shrekwrecks/foc_rpi_micropy/dual_core_foc_micropy.pdf

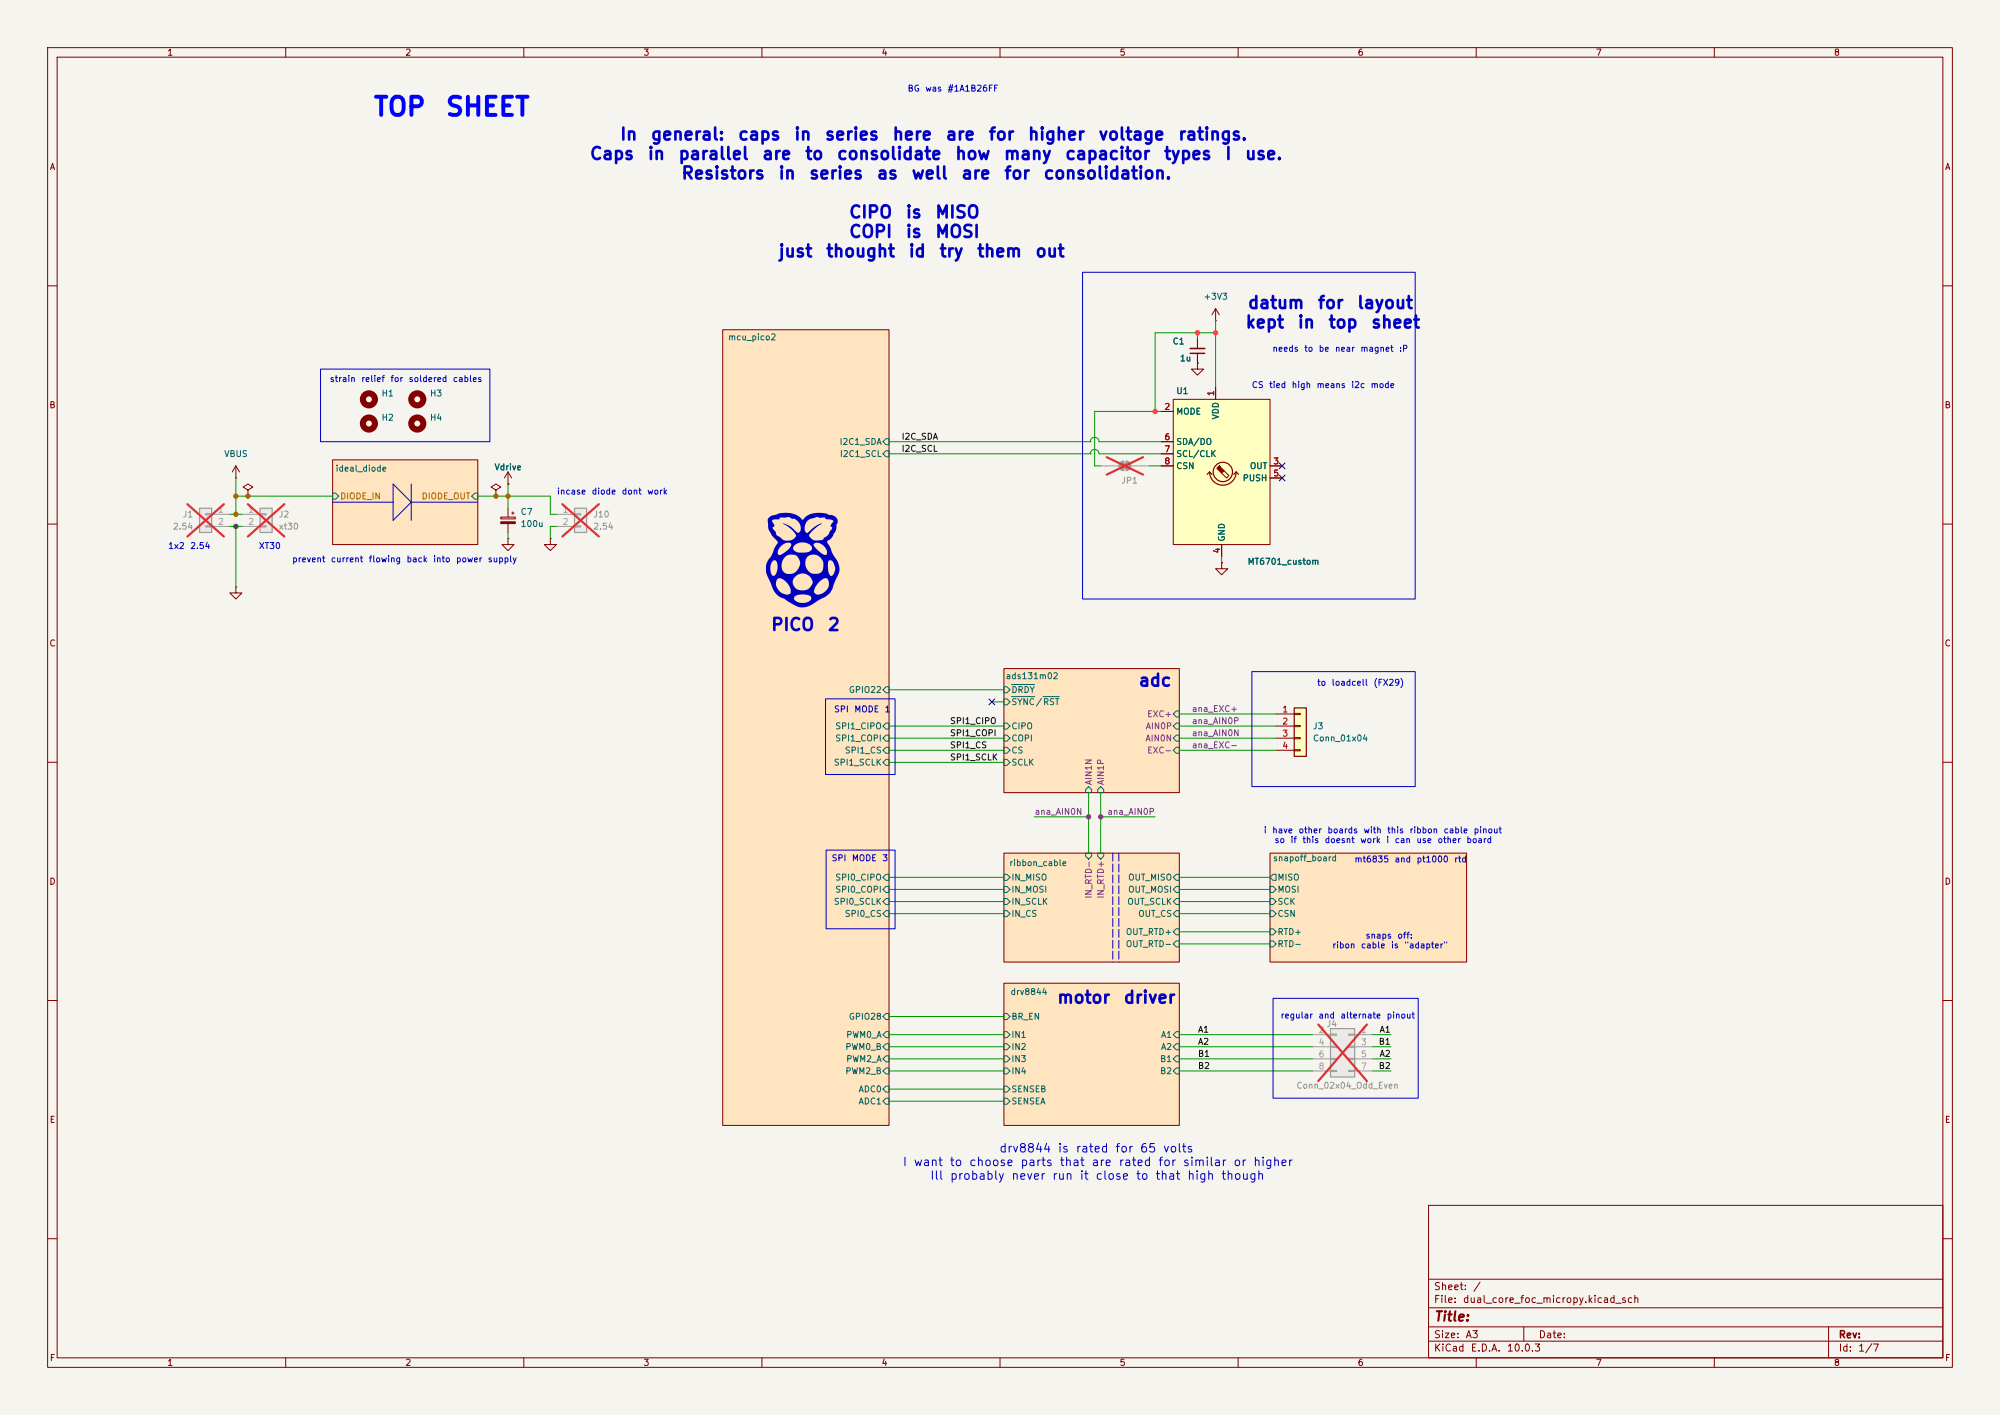
[picture p1: page 1]

strain relief for soldered cables TOP SHEET

In general: caps in series here are for higher voltage ratings.
Caps in parallel are to consolidate how many capacitor types I use.

Resistors in series as well are for consolidation.

just thought id try them out

needs to be near magnet :P datum for layout
kept in top sheet
I2C_SDA SPI1_CIPO
I2C1_SDA SPI0_CIPO
I2C1_SCL

ana_AIN0P | 2

SPI1_COPI SPI1_CS | | ana_AIN0N | 3

ana_EXC- | 4

i have other boards with this ribbon cable pinout so if this doesnt work i can use other board

CSN MISO MOSI SCK

snaps off: ribon cable is "adapter"

regular and alternate pinout
J4 Conn_02x04_Odd_Even

drv8844 is rated for 65 volts

I want to choose parts that are rated for similar or higher
Ill probably never run it close to that high though

Size: A3 | Rev: | F Date:
KiCad E.D.A. 10.0.3 | Id: 1/7

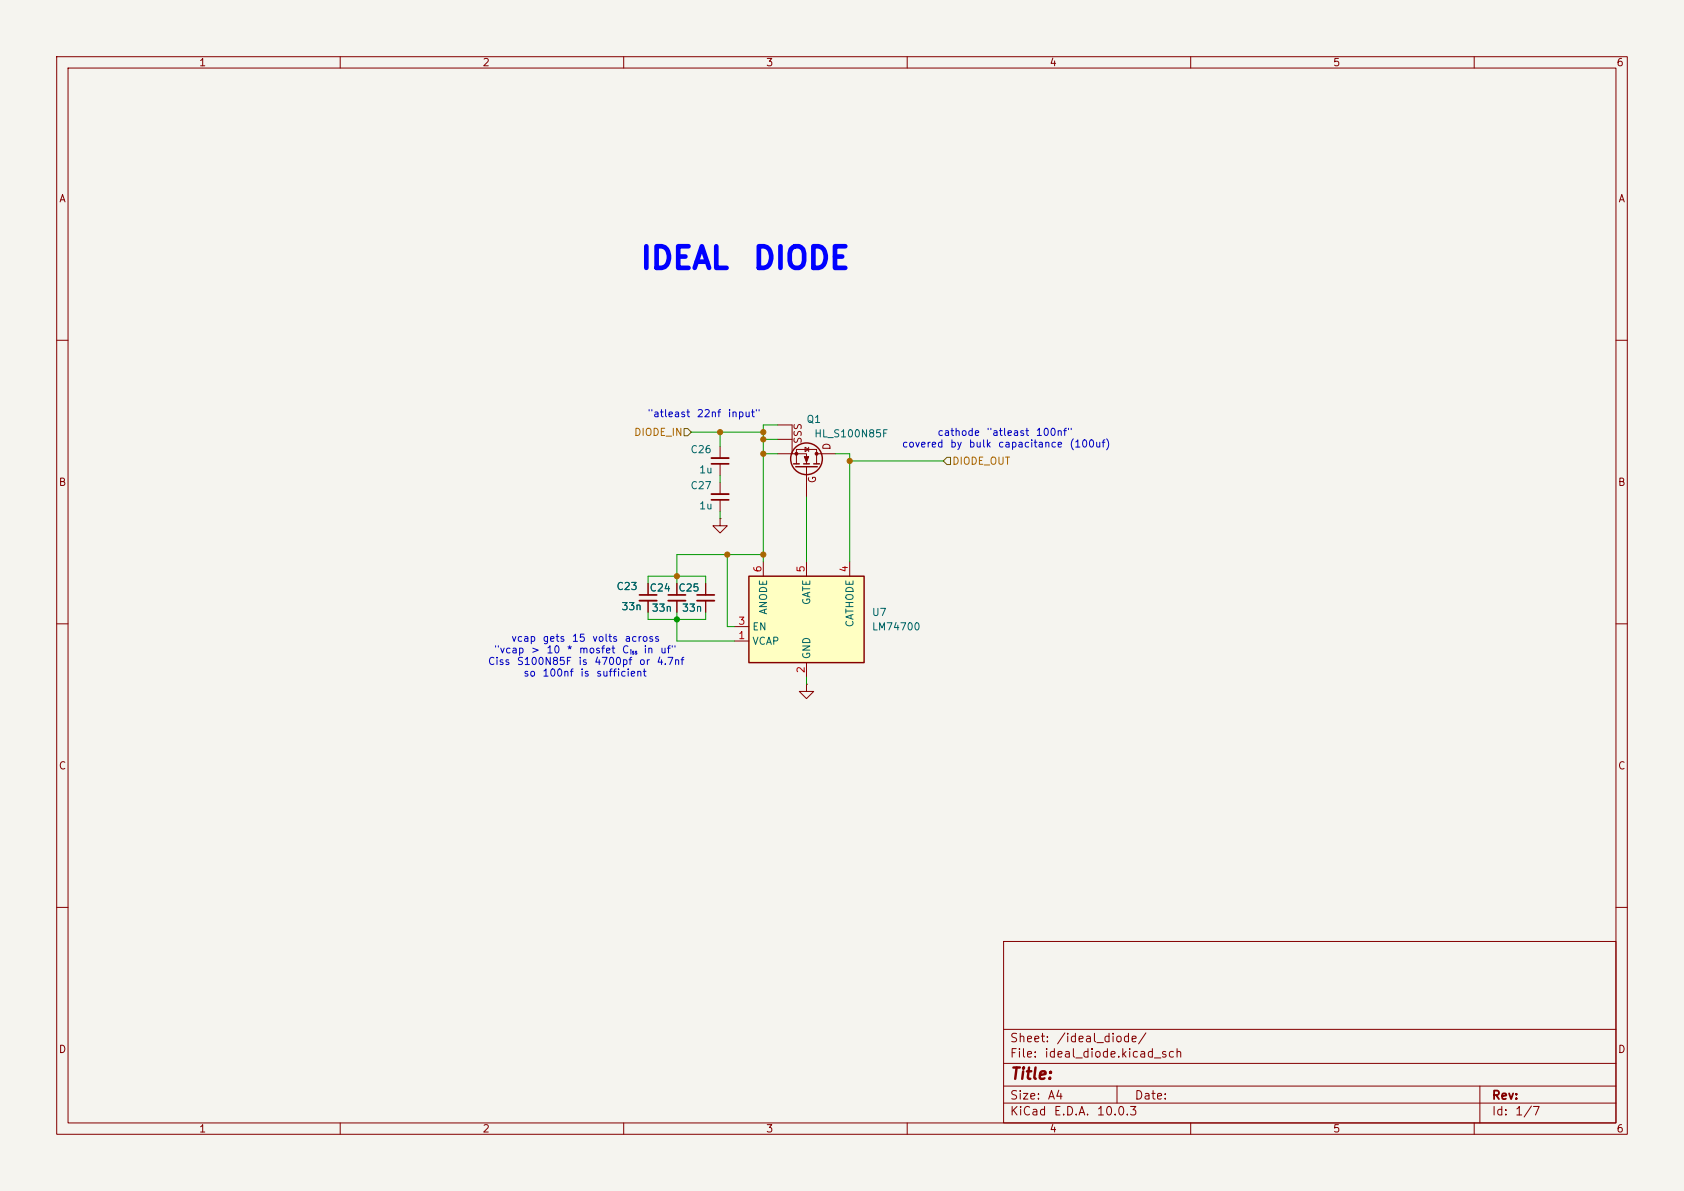
[picture p2: page 2]

"vcap > 10 * mosfet Ciss in uf" Ciss S100N85F is 4700pf or 4.7nf so 100nf is sufficientIDEAL DIODE

DIODE_OUT cathode "atleast 100nf" covered by bulk capacitance (100uf) "atleast 22nf input"
33n DIODE_IN

vcap gets 15 volts across

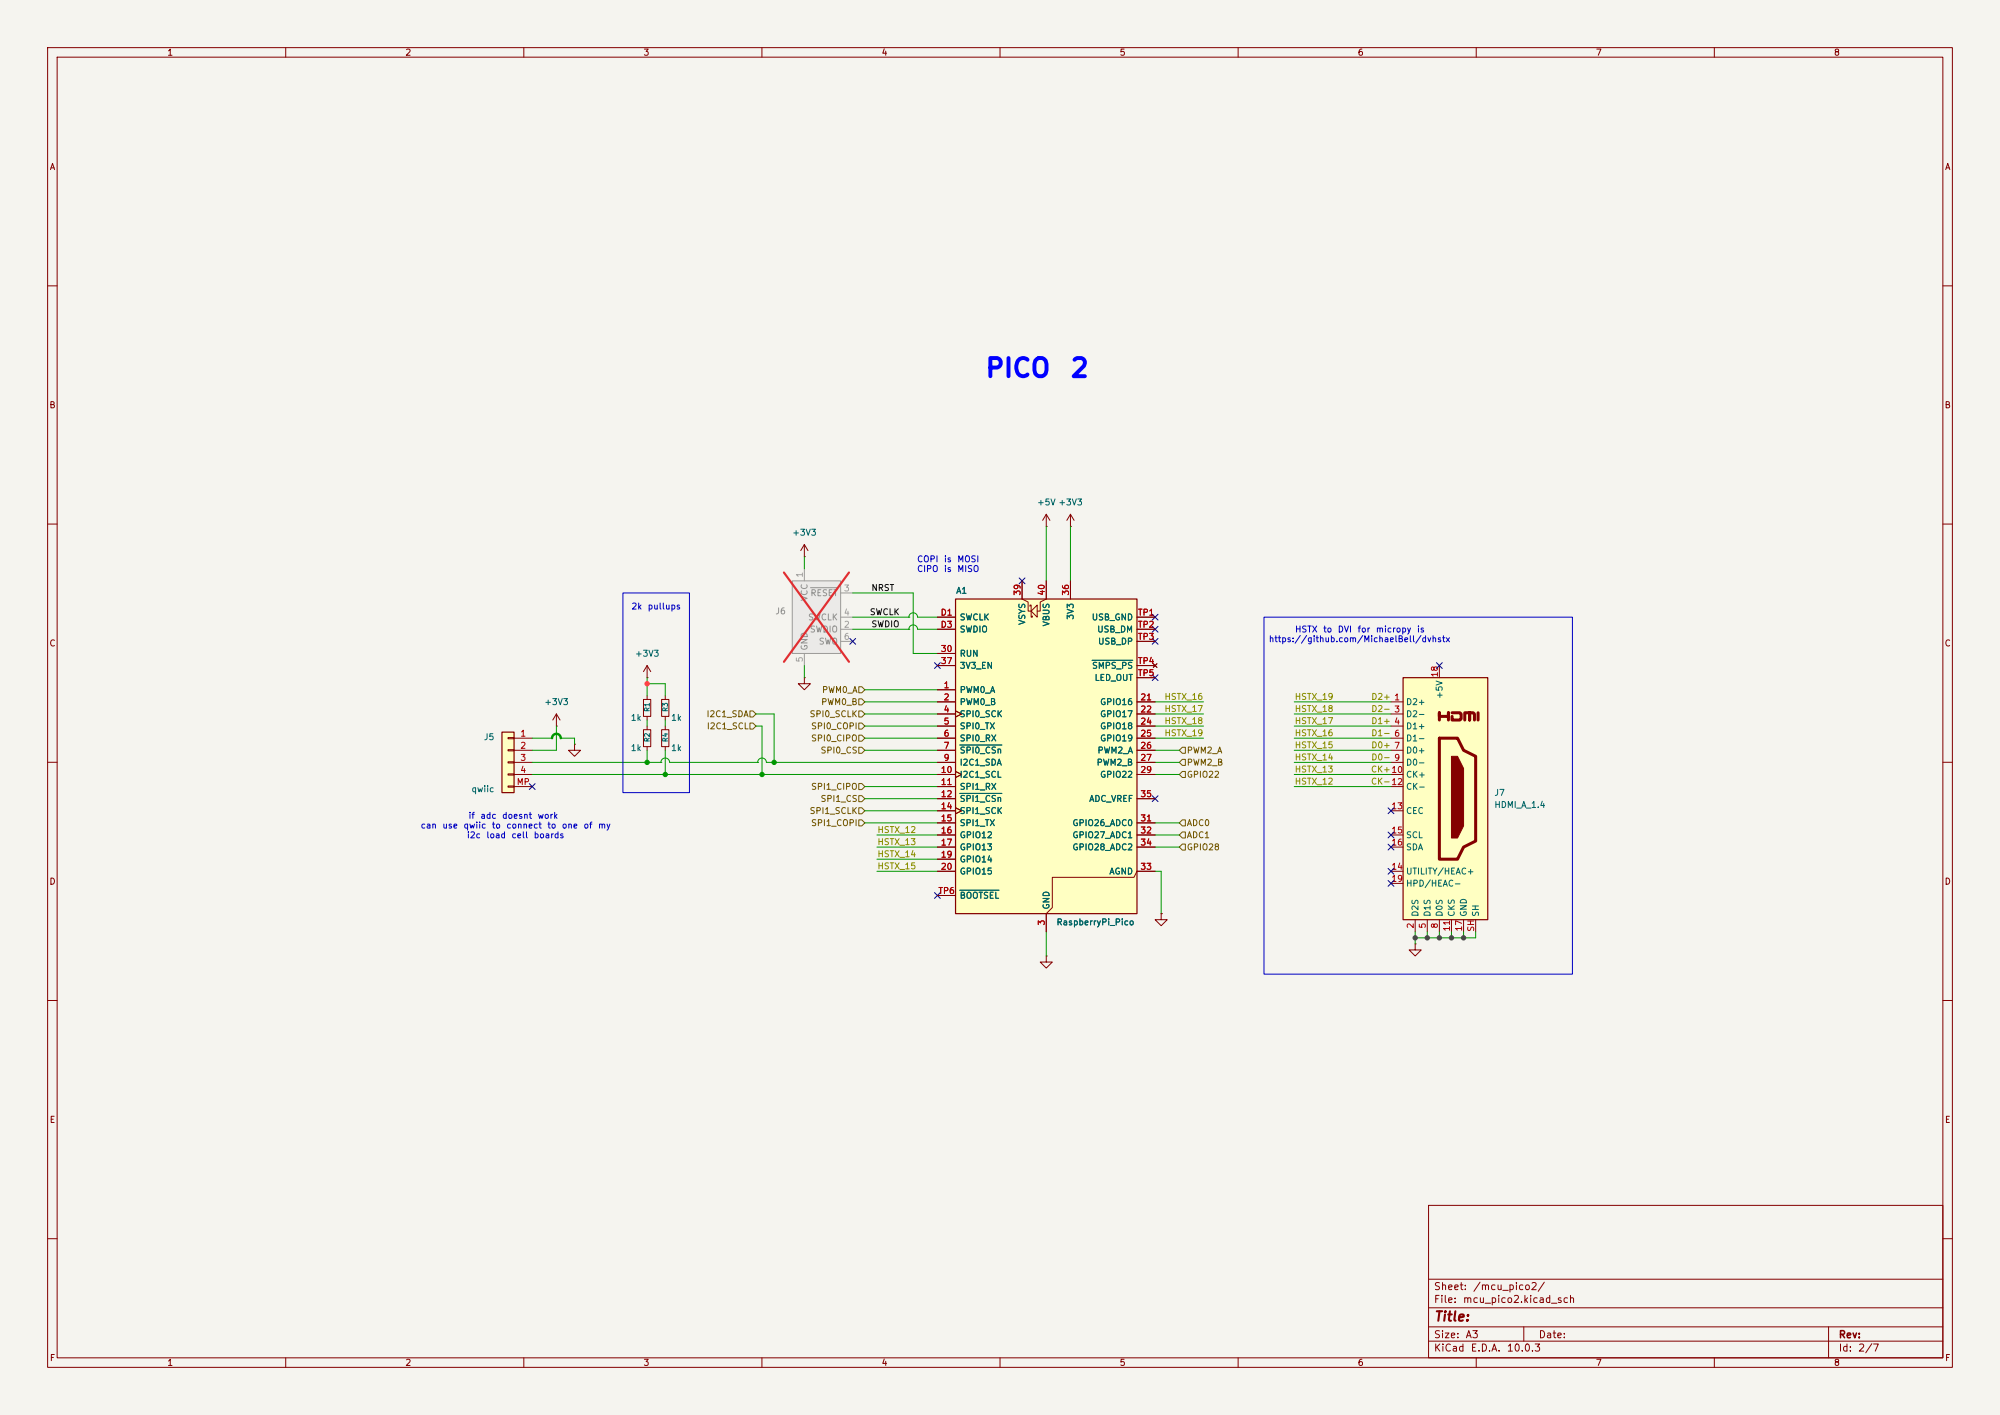
[picture p3: page 3]

8 D0- 9 CK+ 10 CKS 11 CK- 12 CEC 13 UTILITY/HEAC+ 14

if adc doesnt work can use qwiic to connect to one of my

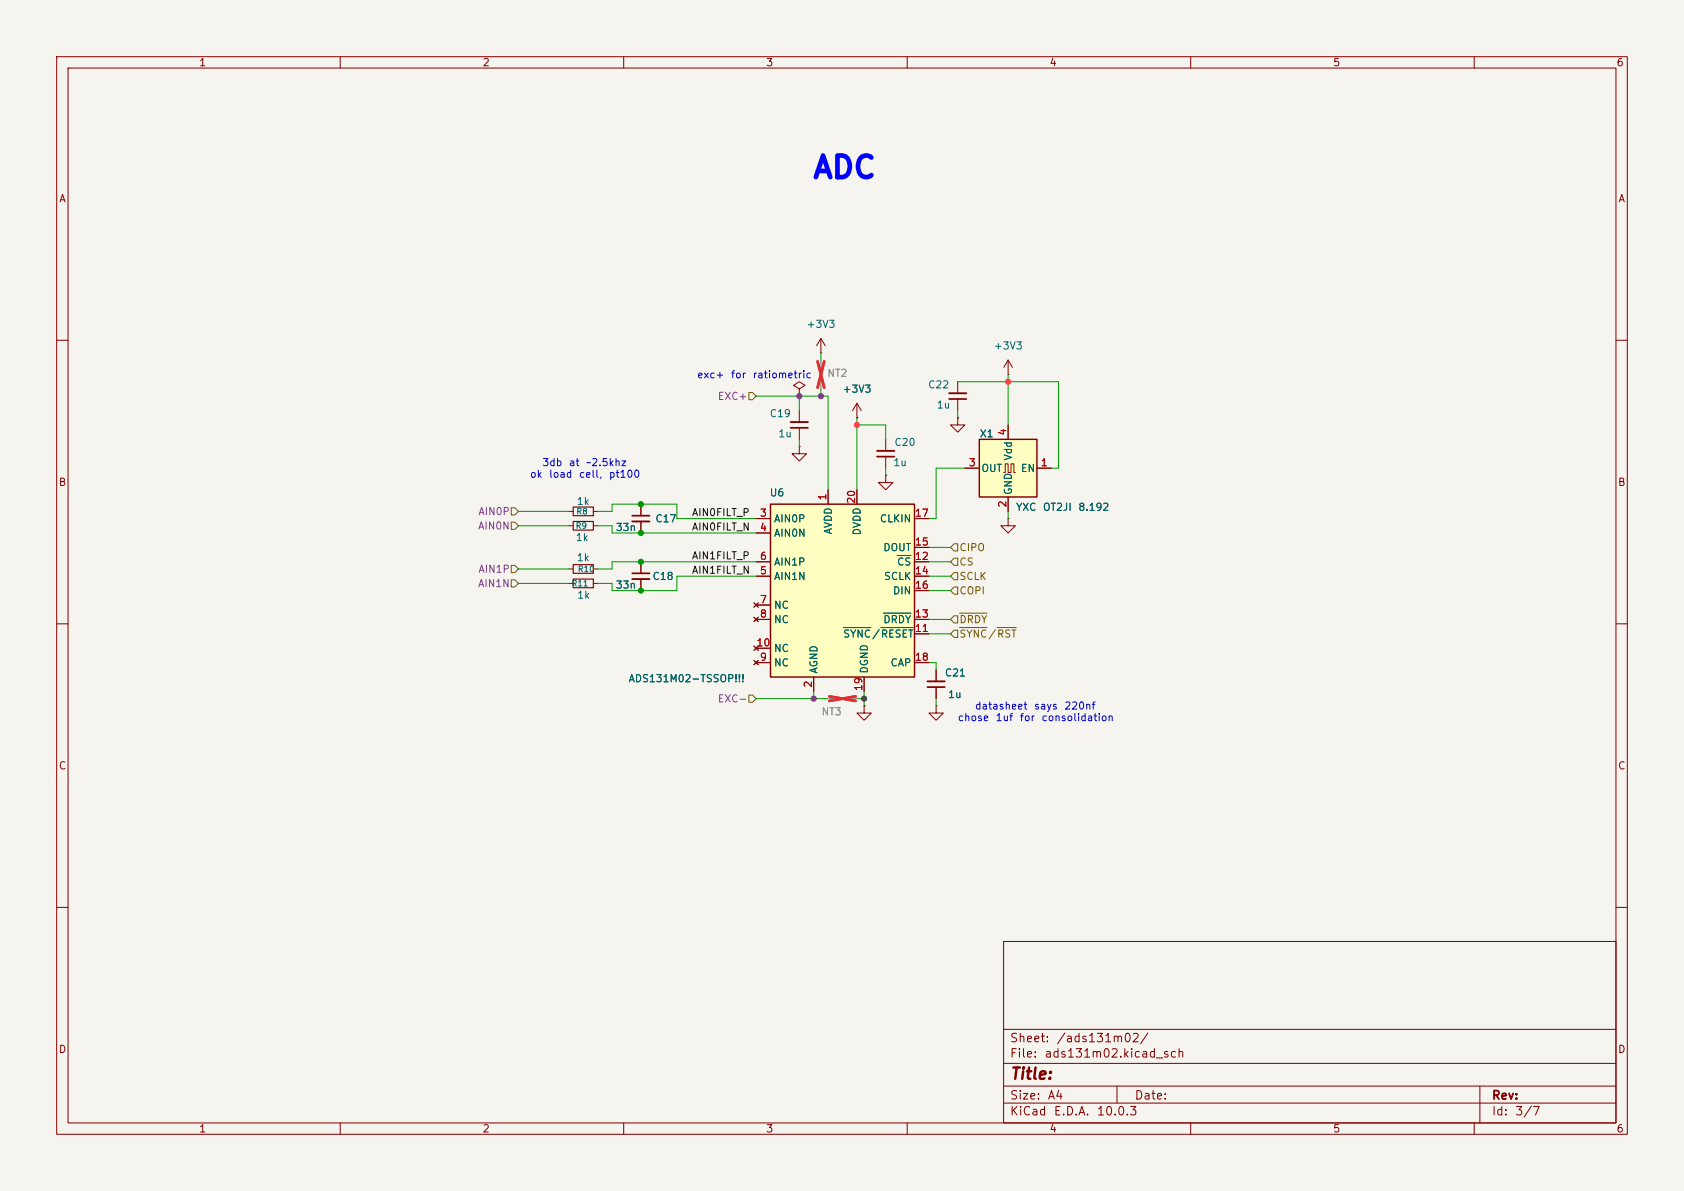
[picture p4: page 4]

CIPO
DRDY SYNC/RST COPI SCLK

datasheet says 220nf chose 1uf for consolidation

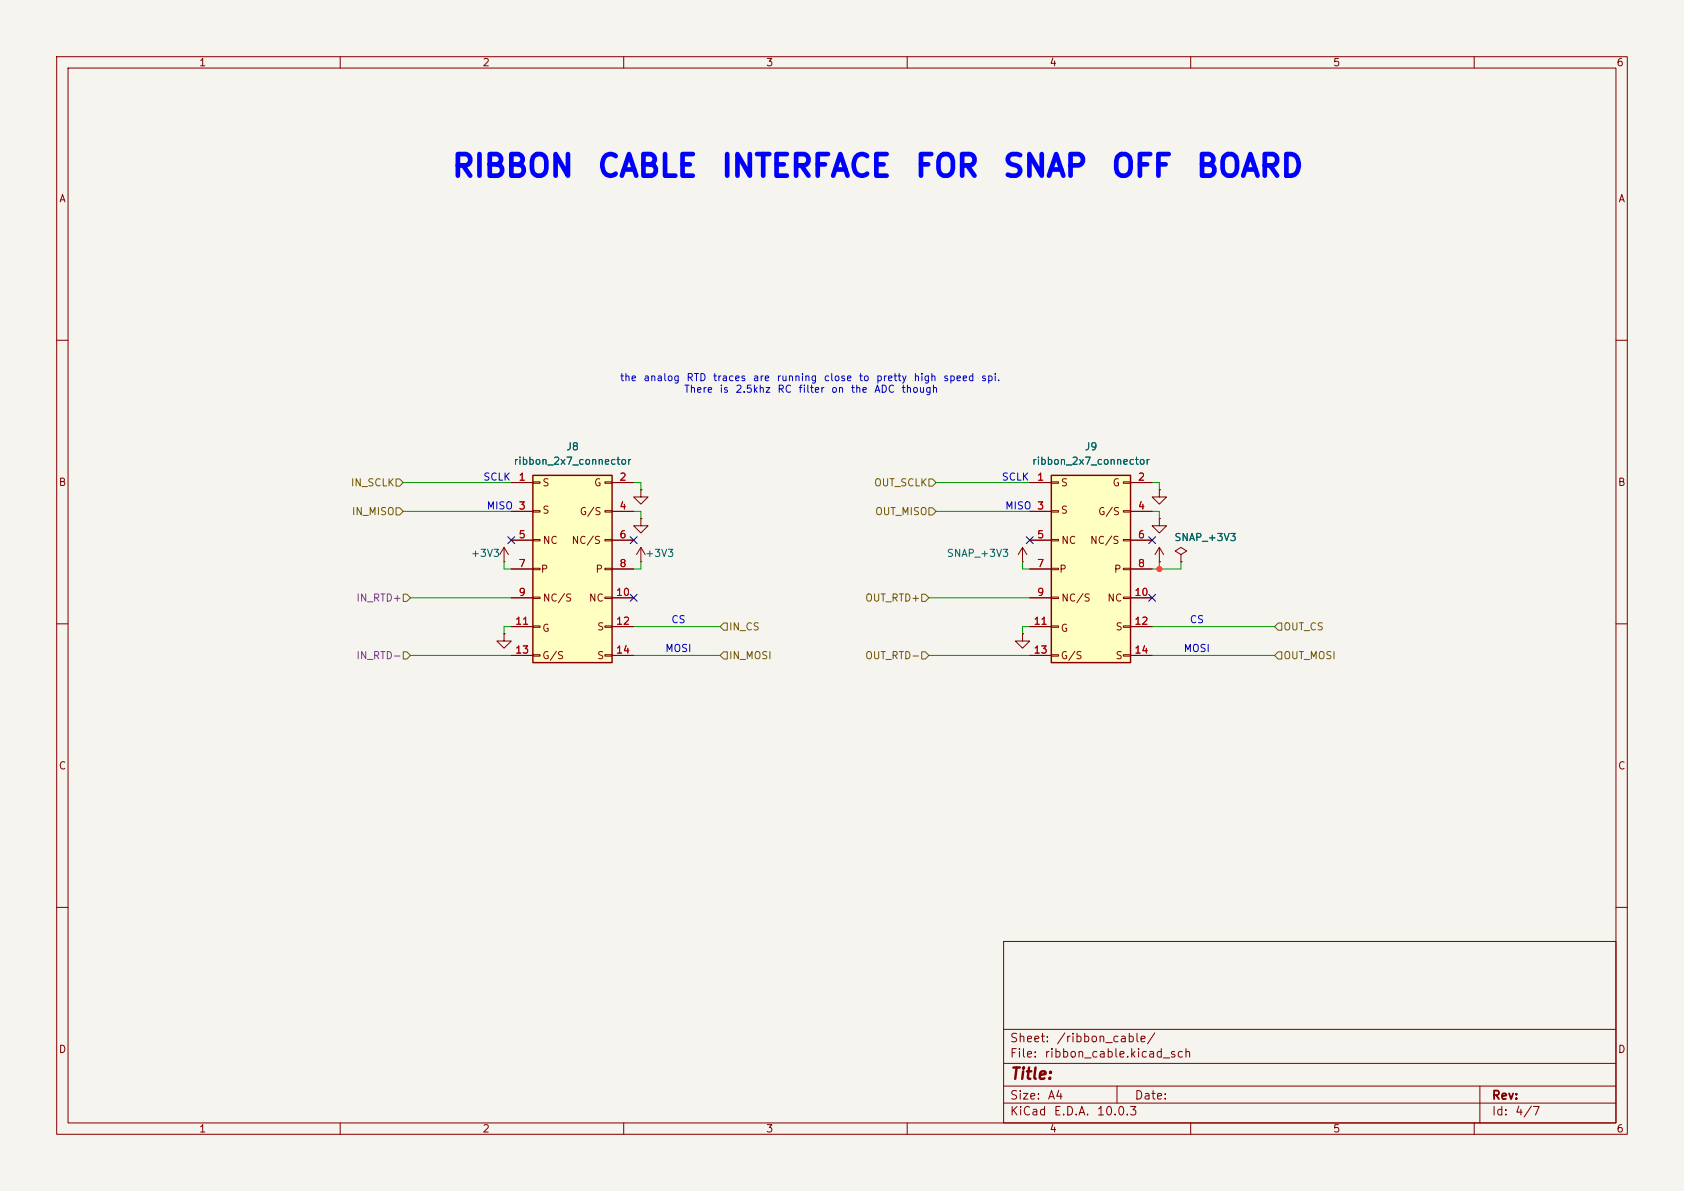
[picture p5: page 5]

RIBBON CABLE INTERFACE FOR SNAP OFF BOARD

the analog RTD traces are running close to pretty high speed spi.

There is 2.5khz RC filter on the ADC though

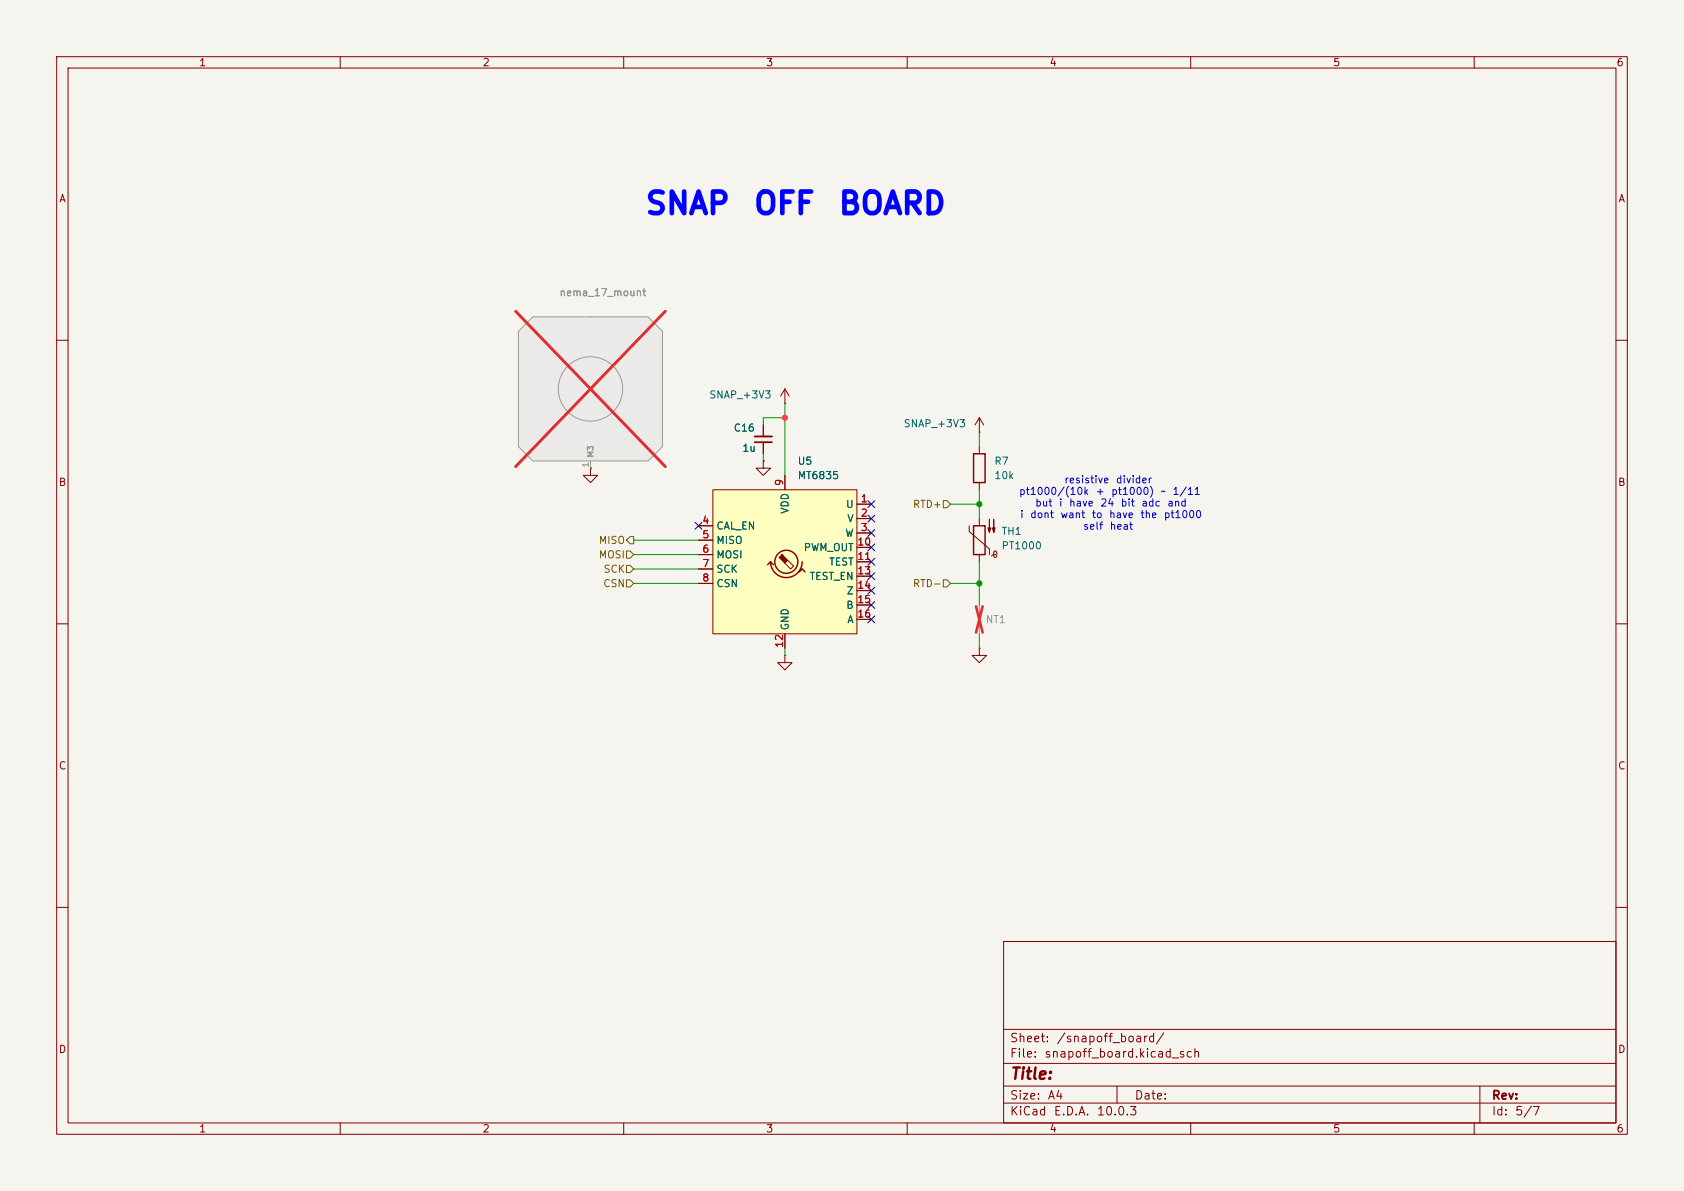
[picture p6: page 6]

self heat SNAP OFF BOARD

but i have 24 bit adc and
i dont want to have the pt1000

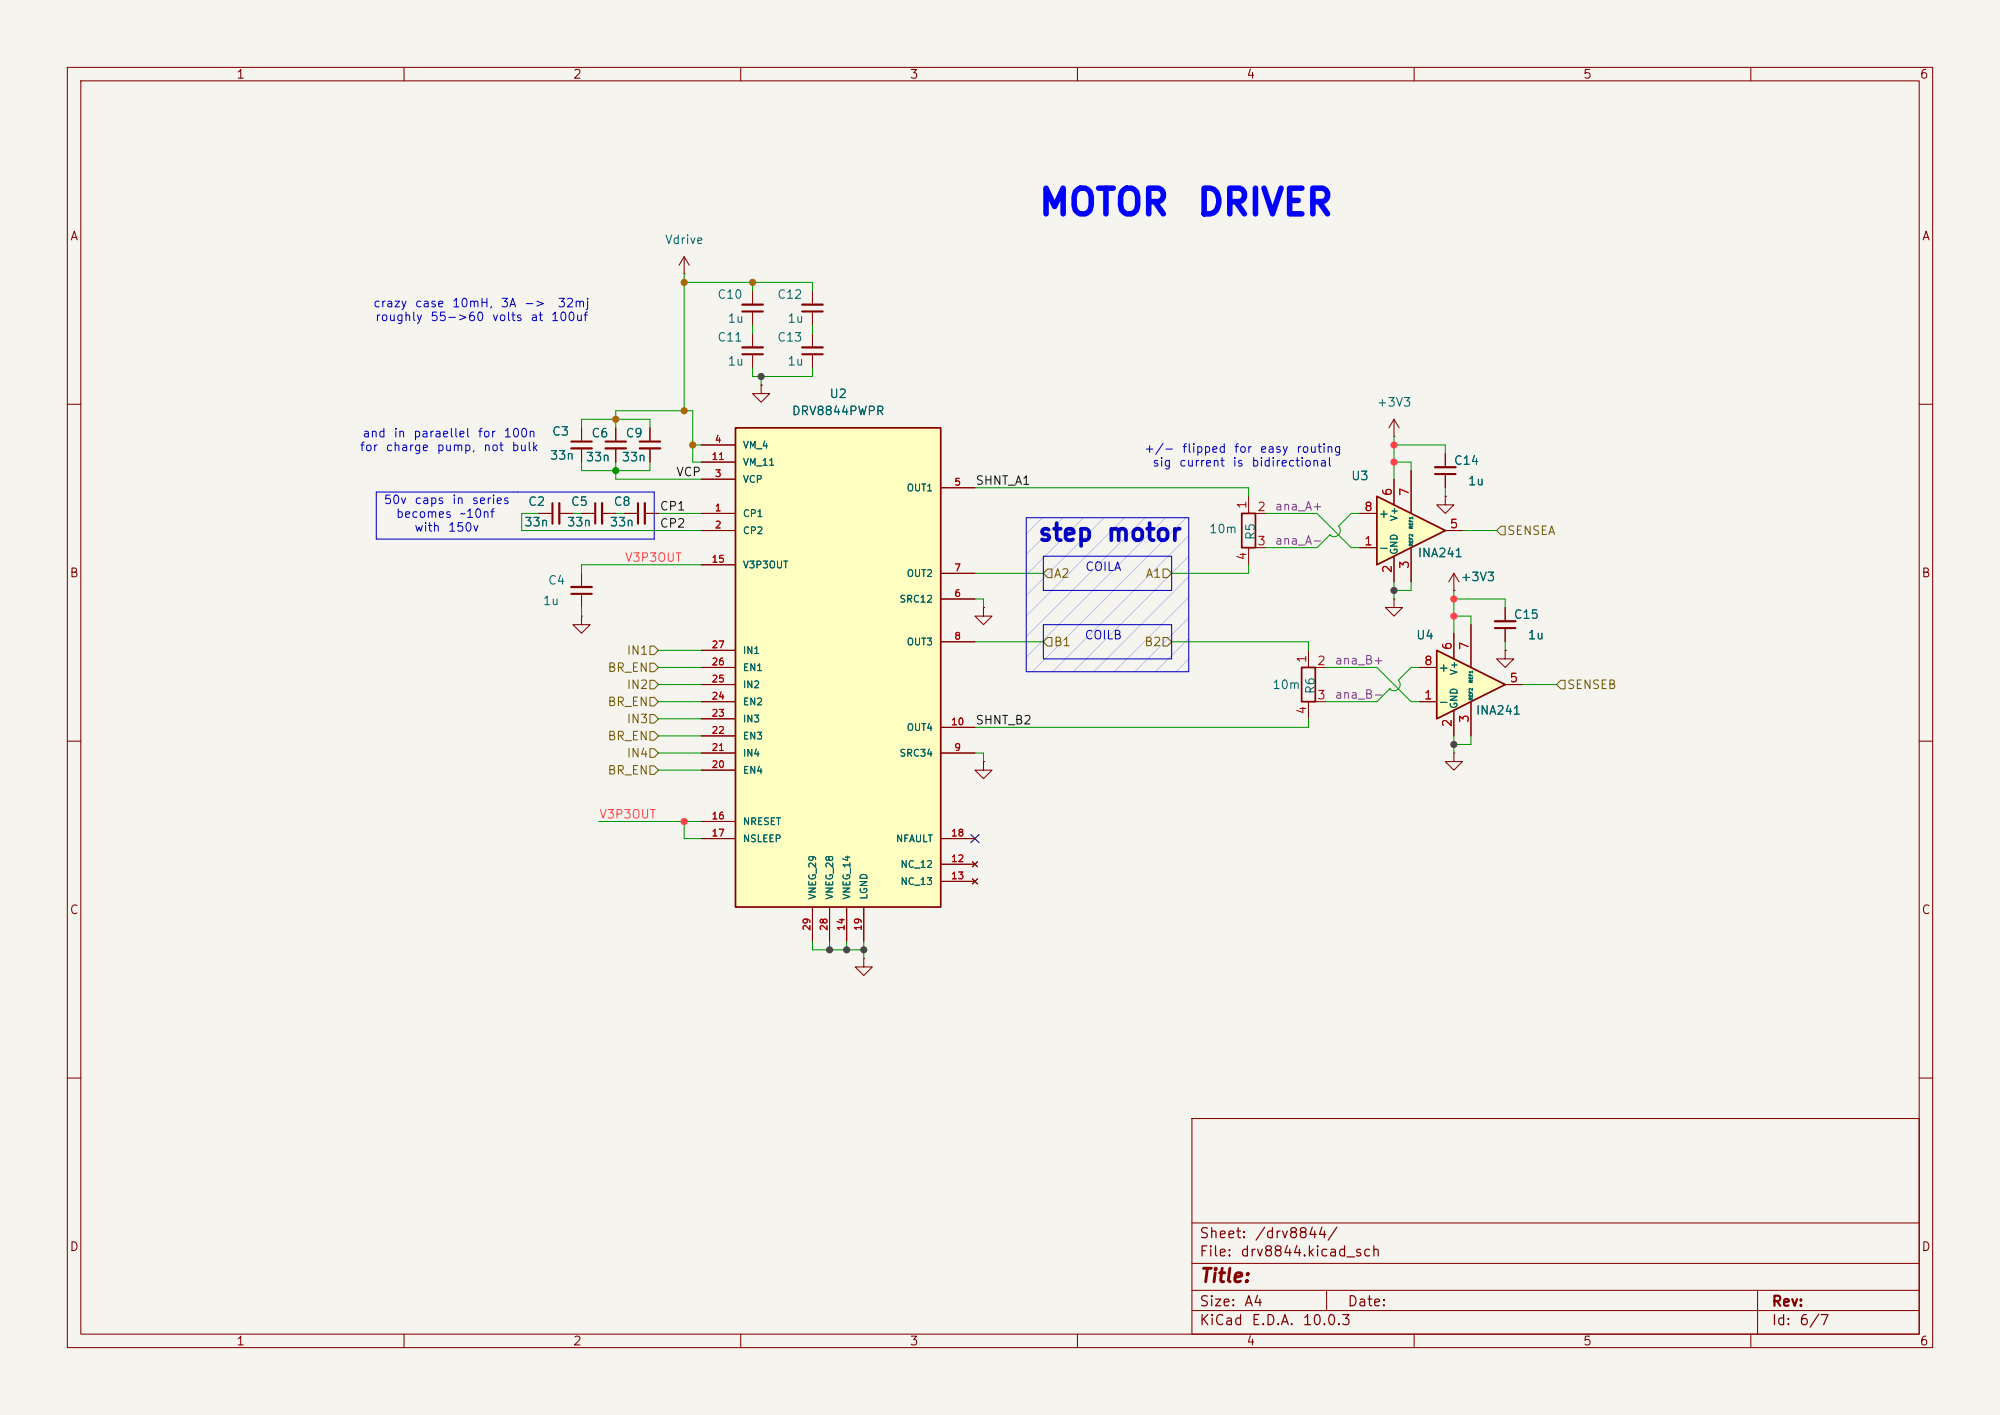
[picture p7: page 7]

for charge pump, not bulk crazy case 10mH, 3A -> 32mj

and in paraellel for 100n
