shrekwrecks/foc_rpi_micropy/dual_core_foc_micropy.kicad_pcb

## KiCad design dual_core_foc_micropy.kicad_pcb (2026-07-04)

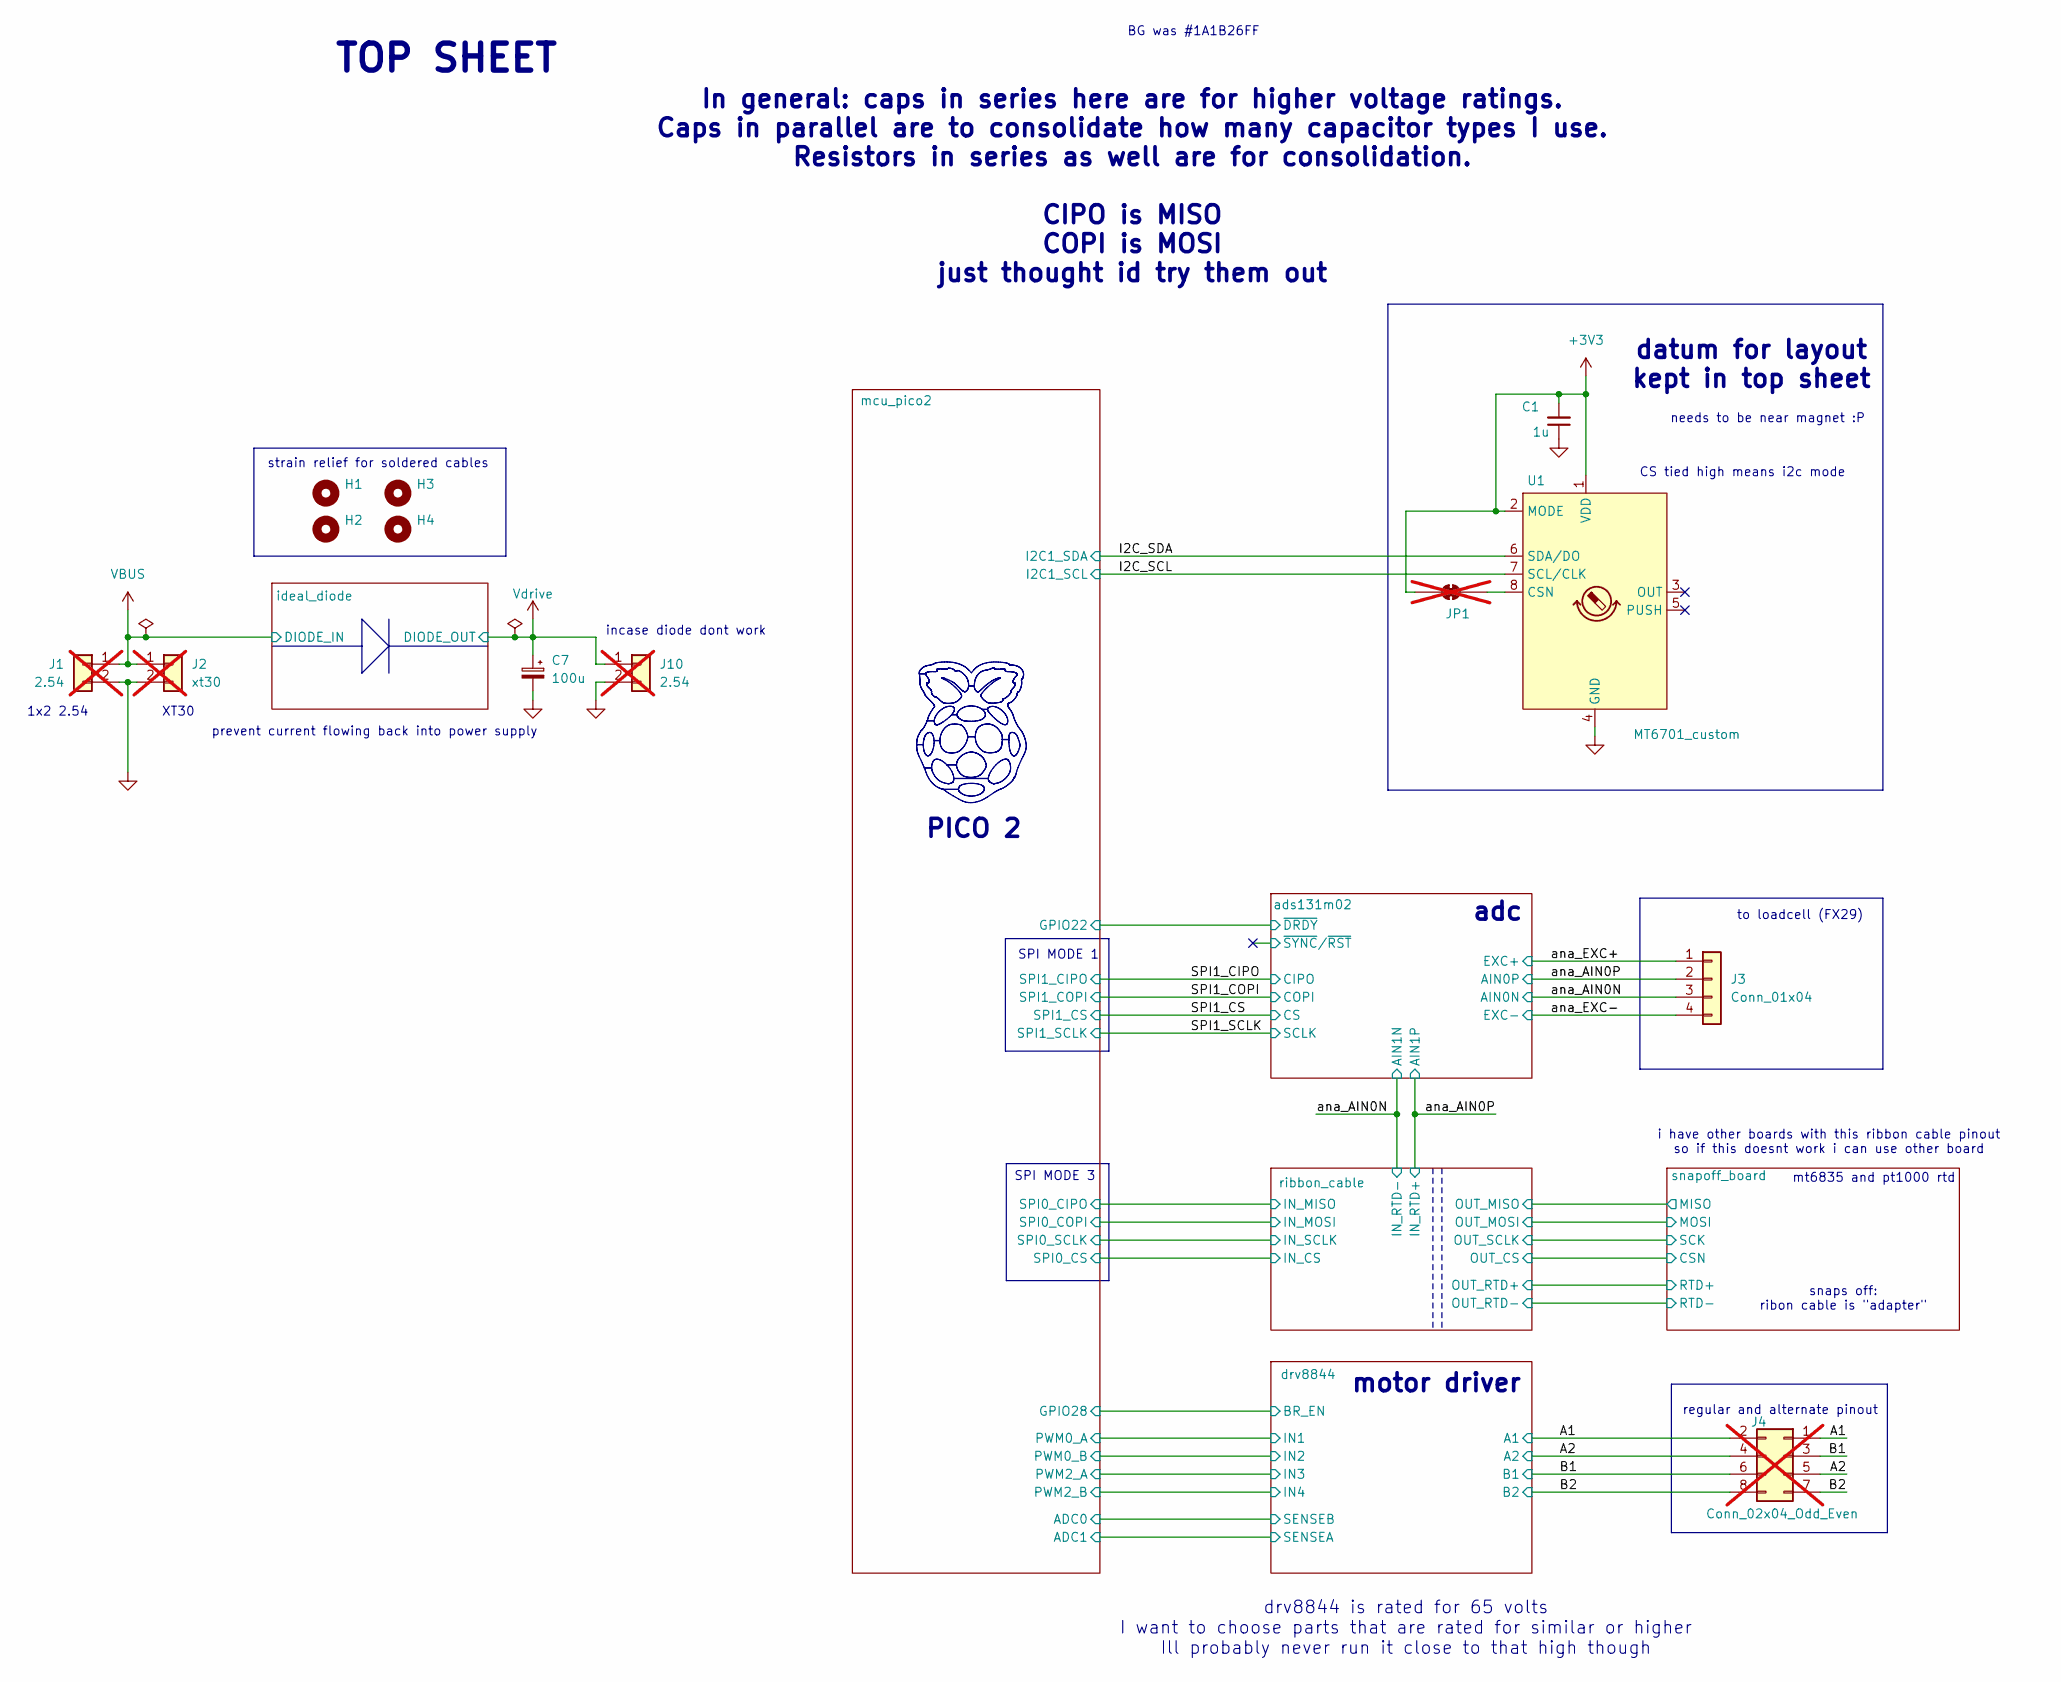
[picture p8: schematic dual_core_foc_micropy.kicad_sch]

Parts:
C1: 1u; C_0603_1608Metric; MPN CL10A105KB8NNNC
C7: 100u; CHEMI-KE0; MPN JVJ100V100M12X13
H1, H2, H3, H4: MountingHole; MountingHole_2.2mm_M2
J1, J10: 2.54; PinHeader_1x02_P2.54mm_Vertical; not fitted
J2: xt30; AMASS_XT30PW-M_1x02_P2.50mm_Horizontal; not fitted
J3: Conn_01x04; PinHeader_1x04_P2.54mm_Vertical
J4: Conn_02x04_Odd_Even; PinHeader_2x04_P2.54mm_Vertical; not fitted
JP1: SolderJumper_2_Bridged; SolderJumper-2_P1.3mm_Bridged_RoundedPad1.0x1.5mm; not fitted
U1: MT6701_custom; SO-8_3.9x4.9mm_P1.27mm; MPN MT6701CT-STD

Connections:
+3V3: C1.2, JP1.1 (A), U1.1 (VDD), U1.2 (MODE); also elsewhere on the board
/A1: J4.1, J4.2; also elsewhere on the board
/A2: J4.4, J4.5; also elsewhere on the board
/B1: J4.3, J4.6; also elsewhere on the board
/B2: J4.7, J4.8; also elsewhere on the board
/I2C_SCL: U1.7 (SCL/CLK); also elsewhere on the board
/I2C_SDA: U1.6 (SDA/DO); also elsewhere on the board
/ana_AIN0N: J3.3; also elsewhere on the board
/ana_AIN0P: J3.2; also elsewhere on the board
/ana_EXC+: J3.1; also elsewhere on the board
/ana_EXC-: J3.4; also elsewhere on the board
GND: C1.1, C7.2, J1.2, J2.2, J10.2, U1.4 (GND); also elsewhere on the board
unnamed: JP1.2 (B), U1.8 (CSN)
VBUS: J1.1, J2.1; also elsewhere on the board
Vdrive: C7.1, J10.1; also elsewhere on the board

Notes on the sheet:
snaps off: ribon cable is "adapter"
mt6835 and pt1000 rtd
i have other boards with this ribbon cable pinout so if this doesnt work i can use other board
regular and alternate pinout
TOP SHEET
prevent current flowing back into power supply
drv8844 is rated for 65 volts I want to choose parts that are rated for similar or higher Ill probably never run it close to that high though
In general: caps in series here are for higher voltage ratings. Caps in parallel are to consolidate how many capacitor types I use. Resistors in series as well are for consolidation. CIPO is MISO COPI is MOSI just thought id try them out
adc
1x2 2.54
strain relief for soldered cables
SPI MODE 1
needs to be near magnet :P
SPI MODE 3
CS tied high means i2c mode
PICO 2
incase diode dont work
XT30
datum for layout kept in top sheet
BG was #1A1B26FF
to loadcell (FX29)
motor driver

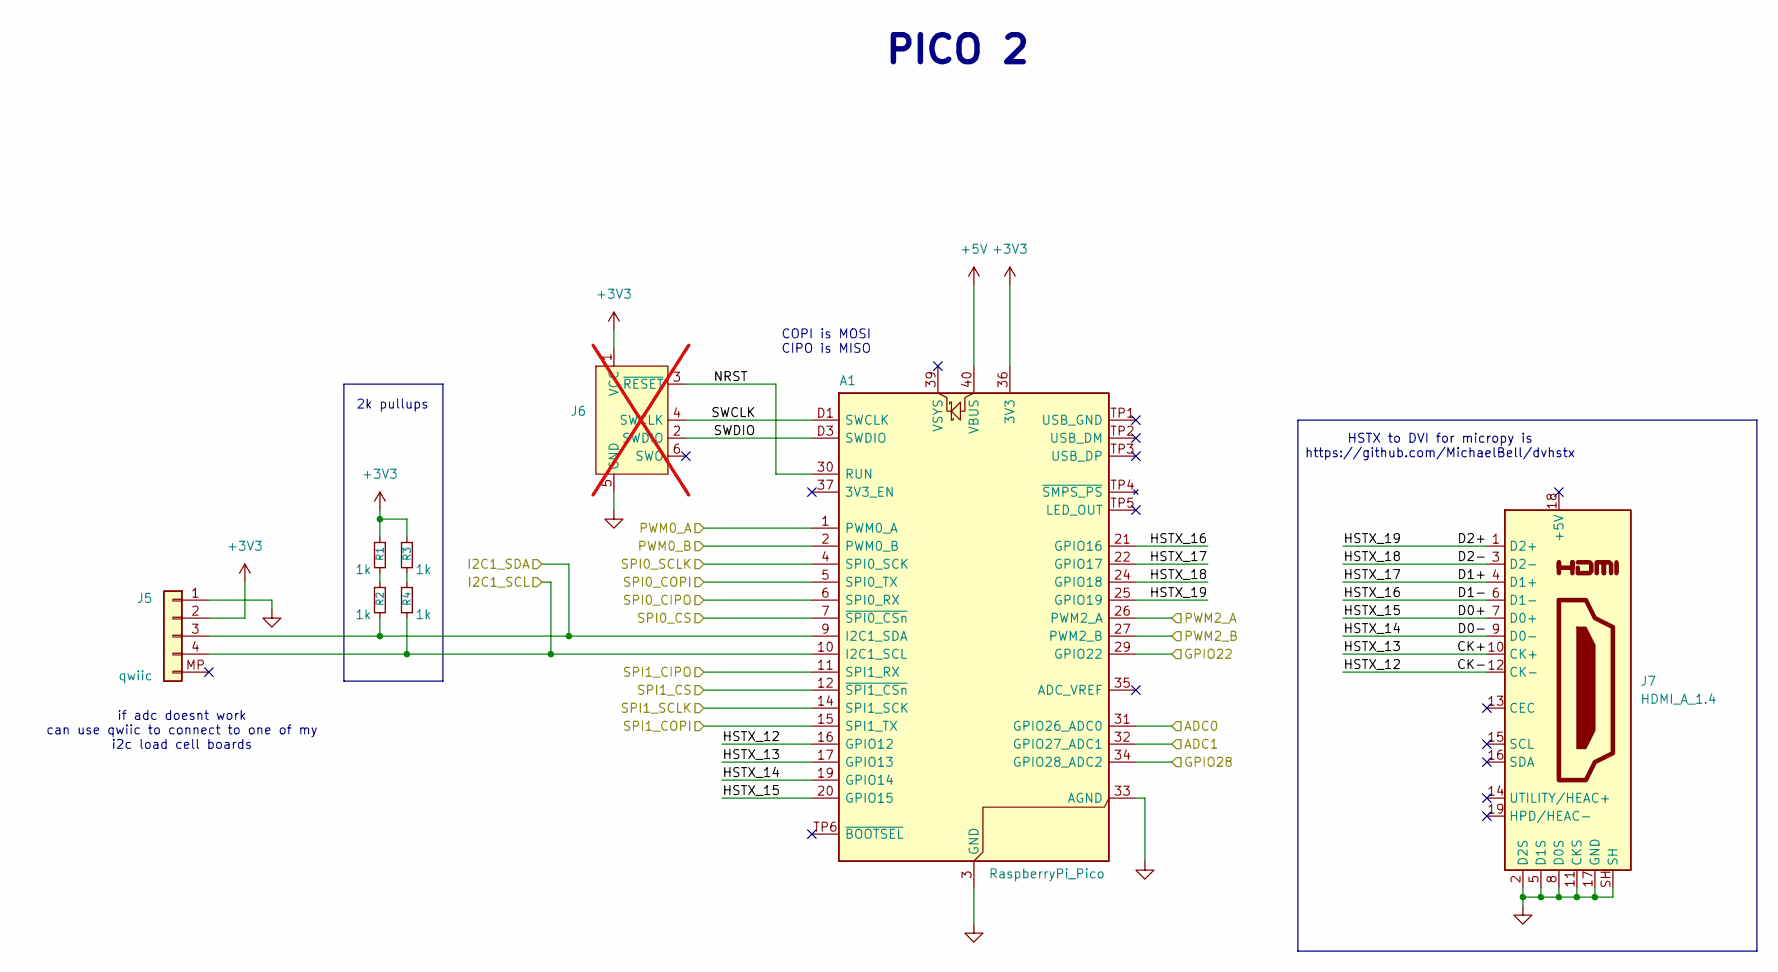
[picture p9: schematic mcu_pico2.kicad_sch]

Parts:
A1: RaspberryPi_Pico; RaspberryPi_Pico_SMD
J5: qwiic; JST_SH_BM04B-SRSS-TB_1x04-1MP_P1.00mm_Vertical; MPN BM04B-SRSS-TB(LF)(SN)
J6: Conn_ARM_SWD_TagConnect_TC2030-NL; Tag-Connect_TC2030-IDC-NL_2x03_P1.27mm_Vertical; not fitted
J7: HDMI_A_1.4; HDMI_A_Amphenol_10029449-x01xLF_Horizontal; MPN 10029449-111RLF
R1, R2, R3, R4: 1k; R_0402_1005Metric; MPN 0402WGF1001TCE

Connections:
+3V3: A1.36 (3V3), J5.2, J6.1 (VCC), R1.1, R3.1; also elsewhere on the board
+5V: A1.40 (VBUS)
/I2C_SCL: A1.10 (I2C1_SCL), J5.4, R4.2; also elsewhere on the board
/I2C_SDA: A1.9 (I2C1_SDA), J5.3, R2.2; also elsewhere on the board
/SPI1_CIPO: A1.11 (SPI1_RX); also elsewhere on the board
/SPI1_COPI: A1.15 (SPI1_TX); also elsewhere on the board
/SPI1_CS: A1.12 (~SPI1_CSn); also elsewhere on the board
/SPI1_SCLK: A1.14 (SPI1_SCK); also elsewhere on the board
/ads131m02/~DRDY: A1.29 (GPIO22); also elsewhere on the board
/drv8844/BR_EN: A1.34 (GPIO28_ADC2); also elsewhere on the board
/drv8844/IN1: A1.1 (PWM0_A); also elsewhere on the board
/drv8844/IN2: A1.2 (PWM0_B); also elsewhere on the board
/drv8844/IN3: A1.26 (PWM2_A); also elsewhere on the board
/drv8844/IN4: A1.27 (PWM2_B); also elsewhere on the board
/drv8844/SENSEA: A1.32 (GPIO27_ADC1); also elsewhere on the board
/drv8844/SENSEB: A1.31 (GPIO26_ADC0); also elsewhere on the board
/mcu_pico2/CK+: A1.17 (GPIO13), J7.10 (CK+)
/mcu_pico2/CK-: A1.16 (GPIO12), J7.12 (CK-)
/mcu_pico2/D0+: A1.20 (GPIO15), J7.7 (D0+)
/mcu_pico2/D0-: A1.19 (GPIO14), J7.9 (D0-)
/mcu_pico2/D1+: A1.22 (GPIO17), J7.4 (D1+)
/mcu_pico2/D1-: A1.21 (GPIO16), J7.6 (D1-)
/mcu_pico2/D2+: A1.25 (GPIO19), J7.1 (D2+)
/mcu_pico2/D2-: A1.24 (GPIO18), J7.3 (D2-)
/mcu_pico2/NRST: A1.30 (RUN), J6.3 (~RESET)
/mcu_pico2/SPI0_CIPO: A1.6 (SPI0_RX); also elsewhere on the board
/mcu_pico2/SPI0_COPI: A1.5 (SPI0_TX); also elsewhere on the board
/mcu_pico2/SPI0_CS: A1.7 (~SPI0_CSn); also elsewhere on the board
/mcu_pico2/SPI0_SCLK: A1.4 (SPI0_SCK); also elsewhere on the board
/mcu_pico2/SWCLK: A1.D1 (SWCLK), J6.4 (SWCLK)
/mcu_pico2/SWDIO: A1.D3 (SWDIO), J6.2 (SWDIO)
GND: A1.3 (GND), A1.8 (GND), A1.13 (GND), A1.18 (GND), A1.23 (GND), A1.28 (GND), A1.33 (AGND), A1.38 (GND), A1.D2 (GND), J5.1, J6.5 (GND), J7.2 (D2S), J7.5 (D1S), J7.8 (D0S), J7.11 (CKS), J7.17 (GND), J7.SH; also elsewhere on the board
unnamed: R1.2, R2.1
unnamed: R3.2, R4.1

Notes on the sheet:
PICO 2
HSTX to DVI for micropy is https://github.com/MichaelBell/dvhstx
2k pullups
COPI is MOSI CIPO is MISO
if adc doesnt work can use qwiic to connect to one of my i2c load cell boards

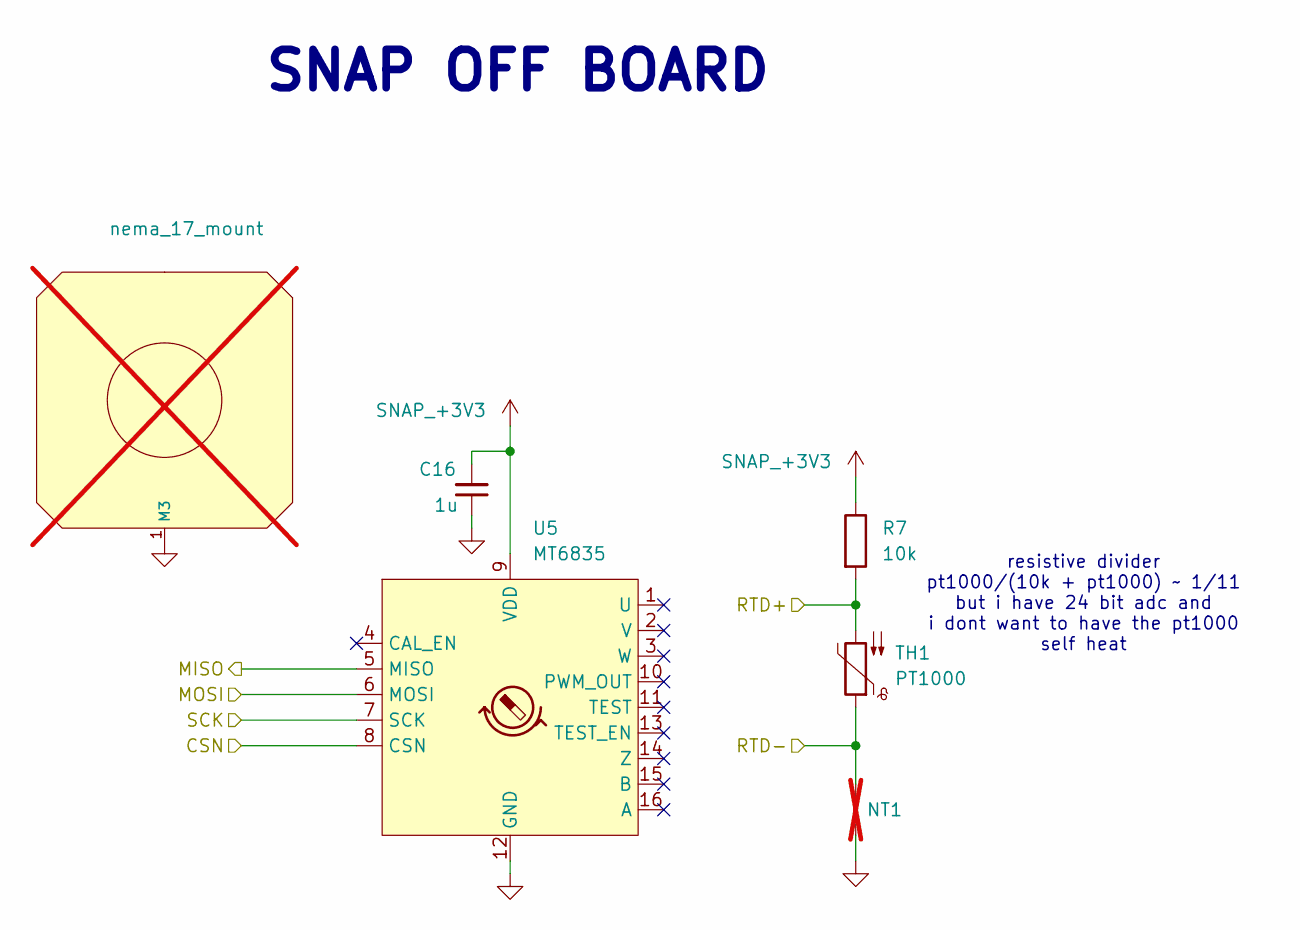
[picture p10: schematic snapoff_board.kicad_sch]

Parts:
C16: 1u; C_0603_1608Metric; MPN CL10A105KB8NNNC
MNT1: nema_17_mount; not fitted
NT1: NetTie_2; NetTie-2_SMD_Pad0.5mm; not fitted
R7: 10k; R_0805_2012Metric_Pad1.20x1.40mm_HandSolder; MPN 0805W8F1002T5E
TH1: PT1000; R_0805_2012Metric; MPN 32207615
U5: MT6835; mt6835; MPN MT6835GT-STD-R

Connections:
/ribbon_cable/OUT_CS: U5.8 (CSN); also elsewhere on the board
/ribbon_cable/OUT_MISO: U5.5 (MISO); also elsewhere on the board
/ribbon_cable/OUT_MOSI: U5.6 (MOSI); also elsewhere on the board
/ribbon_cable/OUT_RTD+: R7.2, TH1.2; also elsewhere on the board
/ribbon_cable/OUT_RTD-: NT1.2, TH1.1; also elsewhere on the board
/ribbon_cable/OUT_SCLK: U5.7 (SCK); also elsewhere on the board
GND: C16.1, MNT1.1 (M3_1), NT1.1, U5.12 (GND); also elsewhere on the board
SNAP_+3V3: C16.2, R7.1, U5.9 (VDD); also elsewhere on the board

Notes on the sheet:
resistive divider pt1000/(10k + pt1000) ~ 1/11 but i have 24 bit adc and i dont want to have the pt1000 self heat
SNAP OFF BOARD

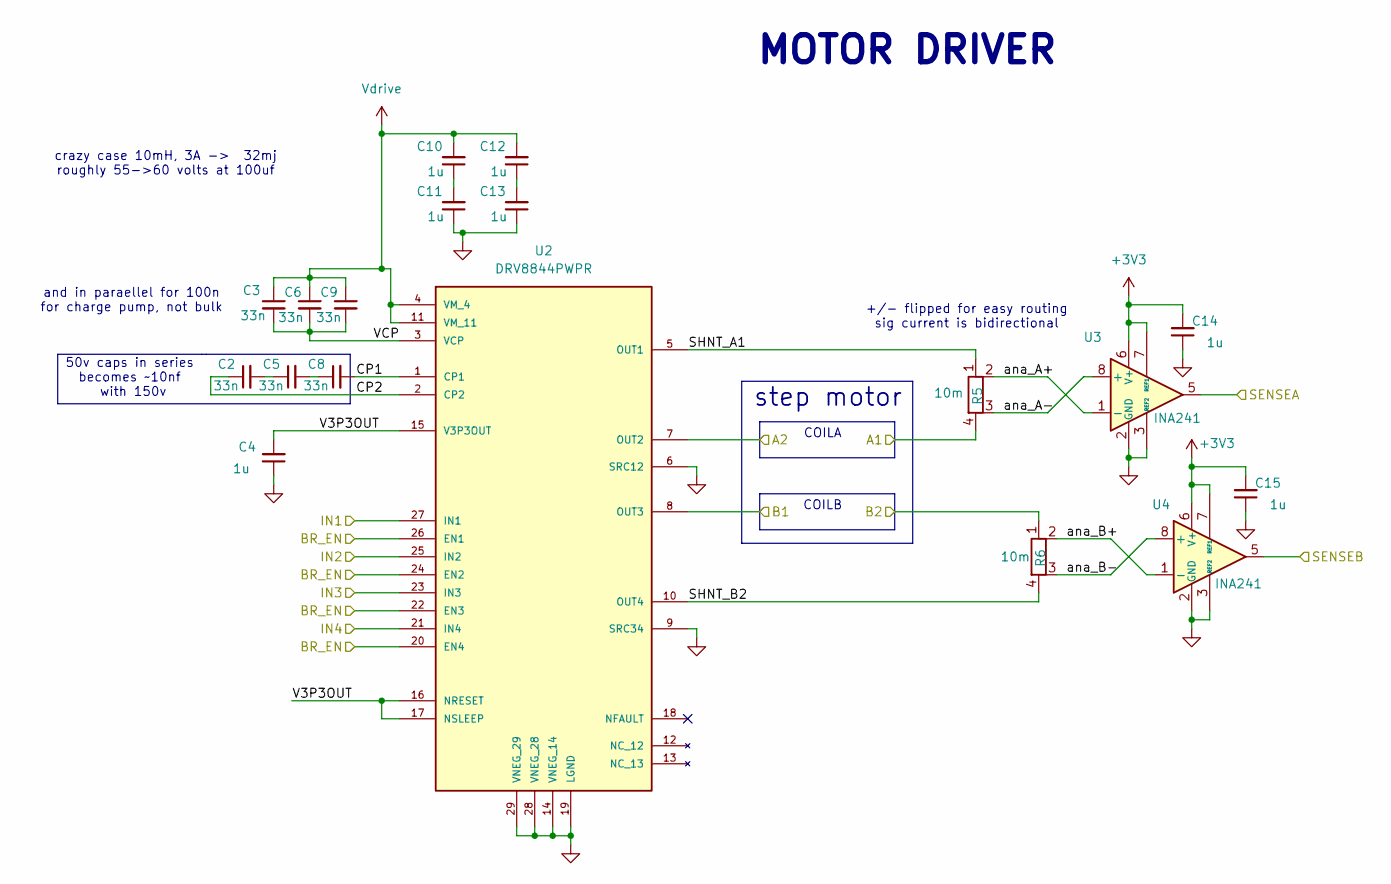
[picture p11: schematic drv8844.kicad_sch]

Parts:
C2, C3, C5, C6, C8, C9: 33n; C_0603_1608Metric; MPN CL10B333KB8NNNC
C4, C10, C11, C12, C13, C14, C15: 1u; C_0603_1608Metric; MPN CL10A105KB8NNNC
R5, R6: 10m; R_1206_resistor_6_pad_kelvin; MPN FRM121WFR010TM
U2: DRV8844PWPR; IC_DRV8844PWPR; PARTREV D
U3, U4: INA241; SOT-23-8; MPN INA241A3IDDFR

Connections:
+3V3: C14.2, C15.2, U3.6 (V+), U3.7 (REF1), U4.6 (V+), U4.7 (REF1); also elsewhere on the board
/A1: R5.4; also elsewhere on the board
/A2: U2.7 (OUT2); also elsewhere on the board
/B1: U2.8 (OUT3); also elsewhere on the board
/B2: R6.1; also elsewhere on the board
/drv8844/BR_EN: U2.20 (EN4), U2.22 (EN3), U2.24 (EN2), U2.26 (EN1); also elsewhere on the board
/drv8844/CP1: C8.2, U2.1 (CP1)
/drv8844/CP2: C2.1, U2.2 (CP2)
/drv8844/IN1: U2.27 (IN1); also elsewhere on the board
/drv8844/IN2: U2.25 (IN2); also elsewhere on the board
/drv8844/IN3: U2.23 (IN3); also elsewhere on the board
/drv8844/IN4: U2.21 (IN4); also elsewhere on the board
/drv8844/SENSEA: U3.5; also elsewhere on the board
/drv8844/SENSEB: U4.5; also elsewhere on the board
/drv8844/SHNT_A1: R5.1, U2.5 (OUT1)
/drv8844/SHNT_B2: R6.4, U2.10 (OUT4)
/drv8844/V3P3OUT: C4.2, U2.15 (V3P3OUT), U2.16 (NRESET), U2.17 (NSLEEP)
/drv8844/VCP: C3.2, C6.2, C9.2, U2.3 (VCP)
/drv8844/ana_A+: R5.2, U3.1 (-)
/drv8844/ana_A-: R5.3, U3.8 (+)
/drv8844/ana_B+: R6.2, U4.1 (-)
/drv8844/ana_B-: R6.3, U4.8 (+)
GND: C4.1, C11.1, C13.1, C14.1, C15.1, U2.6 (SRC12), U2.9 (SRC34), U2.14 (VNEG_14), U2.19 (LGND), U2.28 (VNEG_28), U2.29 (VNEG_29), U3.2 (GND), U3.3 (REF2), U3.4 (GND), U4.2 (GND), U4.3 (REF2), U4.4 (GND); also elsewhere on the board
unnamed: C2.2, C5.1
unnamed: C5.2, C8.1
unnamed: C10.1, C11.2
unnamed: C12.1, C13.2
Vdrive: C3.1, C6.1, C9.1, C10.2, C12.2, U2.4 (VM_4), U2.11 (VM_11); also elsewhere on the board

Notes on the sheet:
crazy case 10mH, 3A -> 32mj roughly 55->60 volts at 100uf
50v caps in series becomes ~10nf with 150v
COILA
COILB
and in paraellel for 100n for charge pump, not bulk
step motor
+/- flipped for easy routing sig current is bidirectional
MOTOR DRIVER

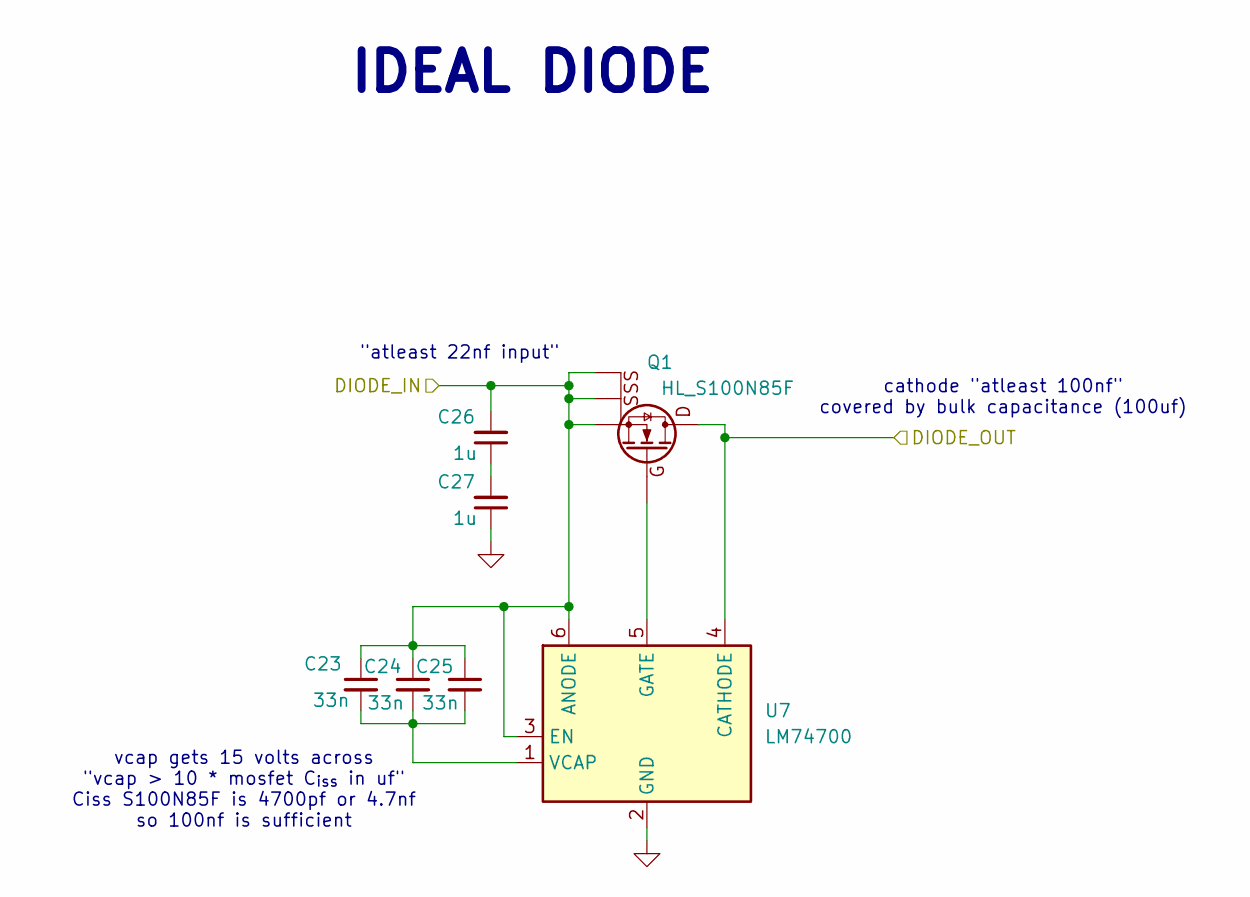
[picture p12: schematic ideal_diode.kicad_sch]

Parts:
C23, C24, C25: 33n; C_0603_1608Metric; MPN CL10B333KB8NNNC
C26, C27: 1u; C_0603_1608Metric; MPN CL10A105KB8NNNC
Q1: HL_S100N85F; PQFN-8-EP_6x5mm_P1.27mm_Generic; MPN S100N85F
U7: LM74700; SOT-23-6

Connections:
GND: C27.1, U7.2 (GND); also elsewhere on the board
unnamed: C26.1, C27.2
unnamed: Q1.4 (G), U7.5 (GATE)
unnamed: C23.2, C24.2, C25.2, U7.1 (VCAP)
VBUS: C23.1, C24.1, C25.1, C26.2, Q1.1 (S), Q1.2 (S), Q1.3 (S), U7.3 (EN), U7.6 (ANODE); also elsewhere on the board
Vdrive: Q1.5 (D), U7.4 (CATHODE); also elsewhere on the board

Notes on the sheet:
cathode "atleast 100nf" covered by bulk capacitance (100uf)
"atleast 22nf input"
vcap gets 15 volts across "vcap > 10 * mosfet C_{iss} in uf" Ciss S100N85F is 4700pf or 4.7nf so 100nf is sufficient
IDEAL DIODE

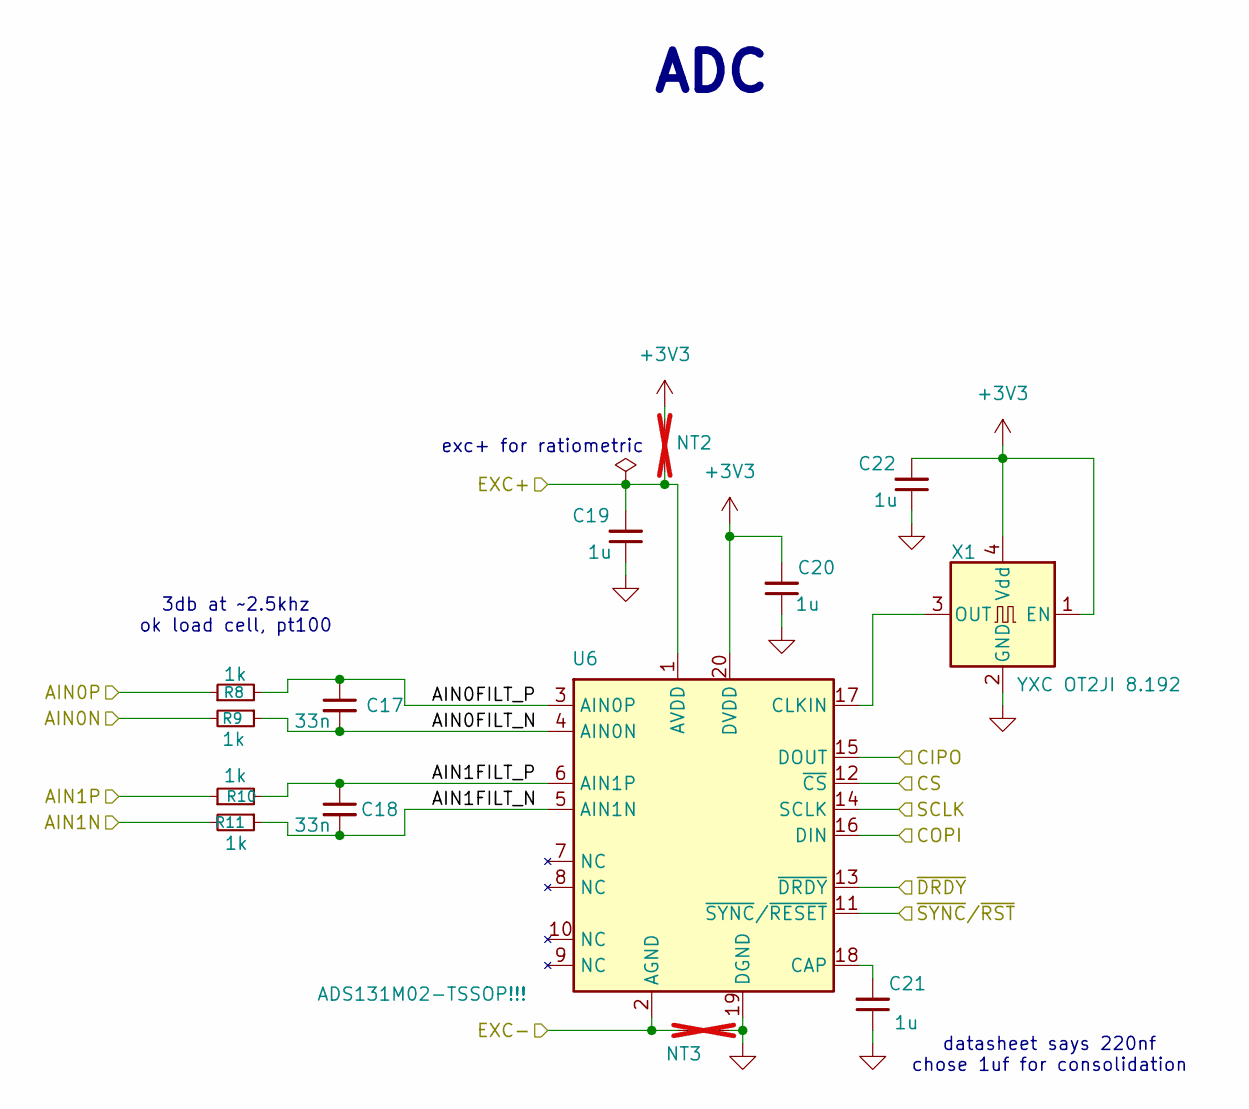
[picture p13: schematic ads131m02.kicad_sch]

Parts:
C17, C18: 33n; C_0603_1608Metric; MPN CL10B333KB8NNNC
C19, C20, C21, C22: 1u; C_0603_1608Metric; MPN CL10A105KB8NNNC
NT2, NT3: NetTie_2; NetTie-2_SMD_Pad0.5mm; not fitted
R8, R9, R10, R11: 1k; R_0402_1005Metric; MPN 0402WGF1001TCE
U6: ADS131M02-TSSOP!!!; TSSOP-20_4.4x6.5mm_P0.65mm; MPN ADS131M02IPWR
X1: YXC OT2JI 8.192; Oscillator_SMD_Abracon_ASE-4Pin_3.2x2.5mm; MPN OT2JI-111-8.192M

Connections:
+3V3: C20.2, C22.2, NT2.2, U6.20 (DVDD), X1.1 (EN), X1.4 (Vdd); also elsewhere on the board
/SPI1_CIPO: U6.15 (DOUT); also elsewhere on the board
/SPI1_COPI: U6.16 (DIN); also elsewhere on the board
/SPI1_CS: U6.12 (~CS); also elsewhere on the board
/SPI1_SCLK: U6.14 (SCLK); also elsewhere on the board
/ads131m02/AIN0FILT_N: C17.2, R9.1, U6.4 (AIN0N)
/ads131m02/AIN0FILT_P: C17.1, R8.2, U6.3 (AIN0P)
/ads131m02/AIN1FILT_N: C18.2, R11.1, U6.5 (AIN1N)
/ads131m02/AIN1FILT_P: C18.1, R10.2, U6.6 (AIN1P)
/ads131m02/~DRDY: U6.13 (~DRDY); also elsewhere on the board
/ads131m02/~SYNC/~RST: U6.11 (~SYNC/~RESET)
/ana_AIN0N: R9.2, R11.2; also elsewhere on the board
/ana_AIN0P: R8.1, R10.1; also elsewhere on the board
/ana_EXC+: C19.2, NT2.1, U6.1 (AVDD); also elsewhere on the board
/ana_EXC-: NT3.2, U6.2 (AGND); also elsewhere on the board
GND: C19.1, C20.1, C21.1, C22.1, NT3.1, U6.19 (DGND), X1.2 (GND); also elsewhere on the board
unnamed: C21.2, U6.18 (CAP)
unnamed: U6.17 (CLKIN), X1.3 (OUT)

Notes on the sheet:
ADC
datasheet says 220nf chose 1uf for consolidation
3db at ~2.5khz ok load cell, pt100
exc+ for ratiometric

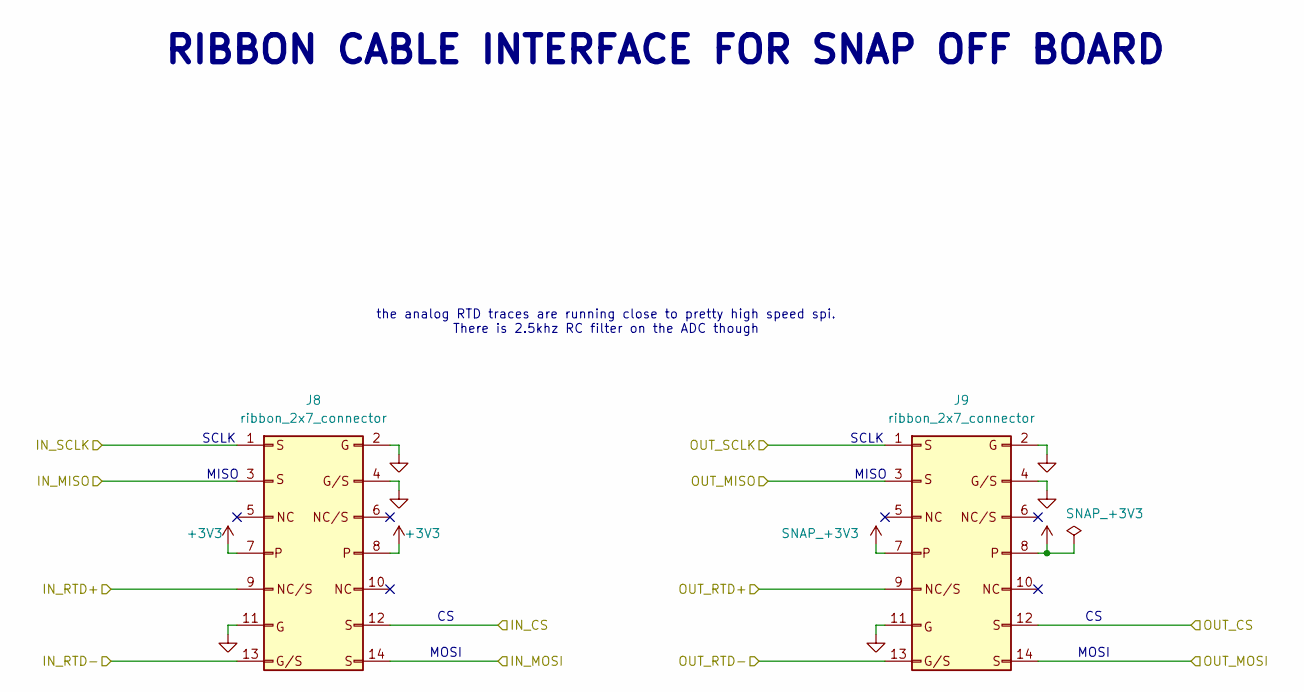
[picture p14: schematic ribbon_cable.kicad_sch]

Parts:
J8, J9: ribbon_2x7_connector; idc_1.27_smd_2x7

Connections:
+3V3: J8.7, J8.8; also elsewhere on the board
/ana_AIN0N: J8.13; also elsewhere on the board
/ana_AIN0P: J8.9; also elsewhere on the board
/mcu_pico2/SPI0_CIPO: J8.3; also elsewhere on the board
/mcu_pico2/SPI0_COPI: J8.14; also elsewhere on the board
/mcu_pico2/SPI0_CS: J8.12; also elsewhere on the board
/mcu_pico2/SPI0_SCLK: J8.1; also elsewhere on the board
/ribbon_cable/OUT_CS: J9.12; also elsewhere on the board
/ribbon_cable/OUT_MISO: J9.3; also elsewhere on the board
/ribbon_cable/OUT_MOSI: J9.14; also elsewhere on the board
/ribbon_cable/OUT_RTD+: J9.9; also elsewhere on the board
/ribbon_cable/OUT_RTD-: J9.13; also elsewhere on the board
/ribbon_cable/OUT_SCLK: J9.1; also elsewhere on the board
GND: J8.2, J8.4, J8.11, J9.2, J9.4, J9.11; also elsewhere on the board
SNAP_+3V3: J9.7, J9.8; also elsewhere on the board

Notes on the sheet:
MOSI
RIBBON CABLE INTERFACE FOR SNAP OFF BOARD
MISO
the analog RTD traces are running close to pretty high speed spi. There is 2.5khz RC filter on the ADC though
SCLK

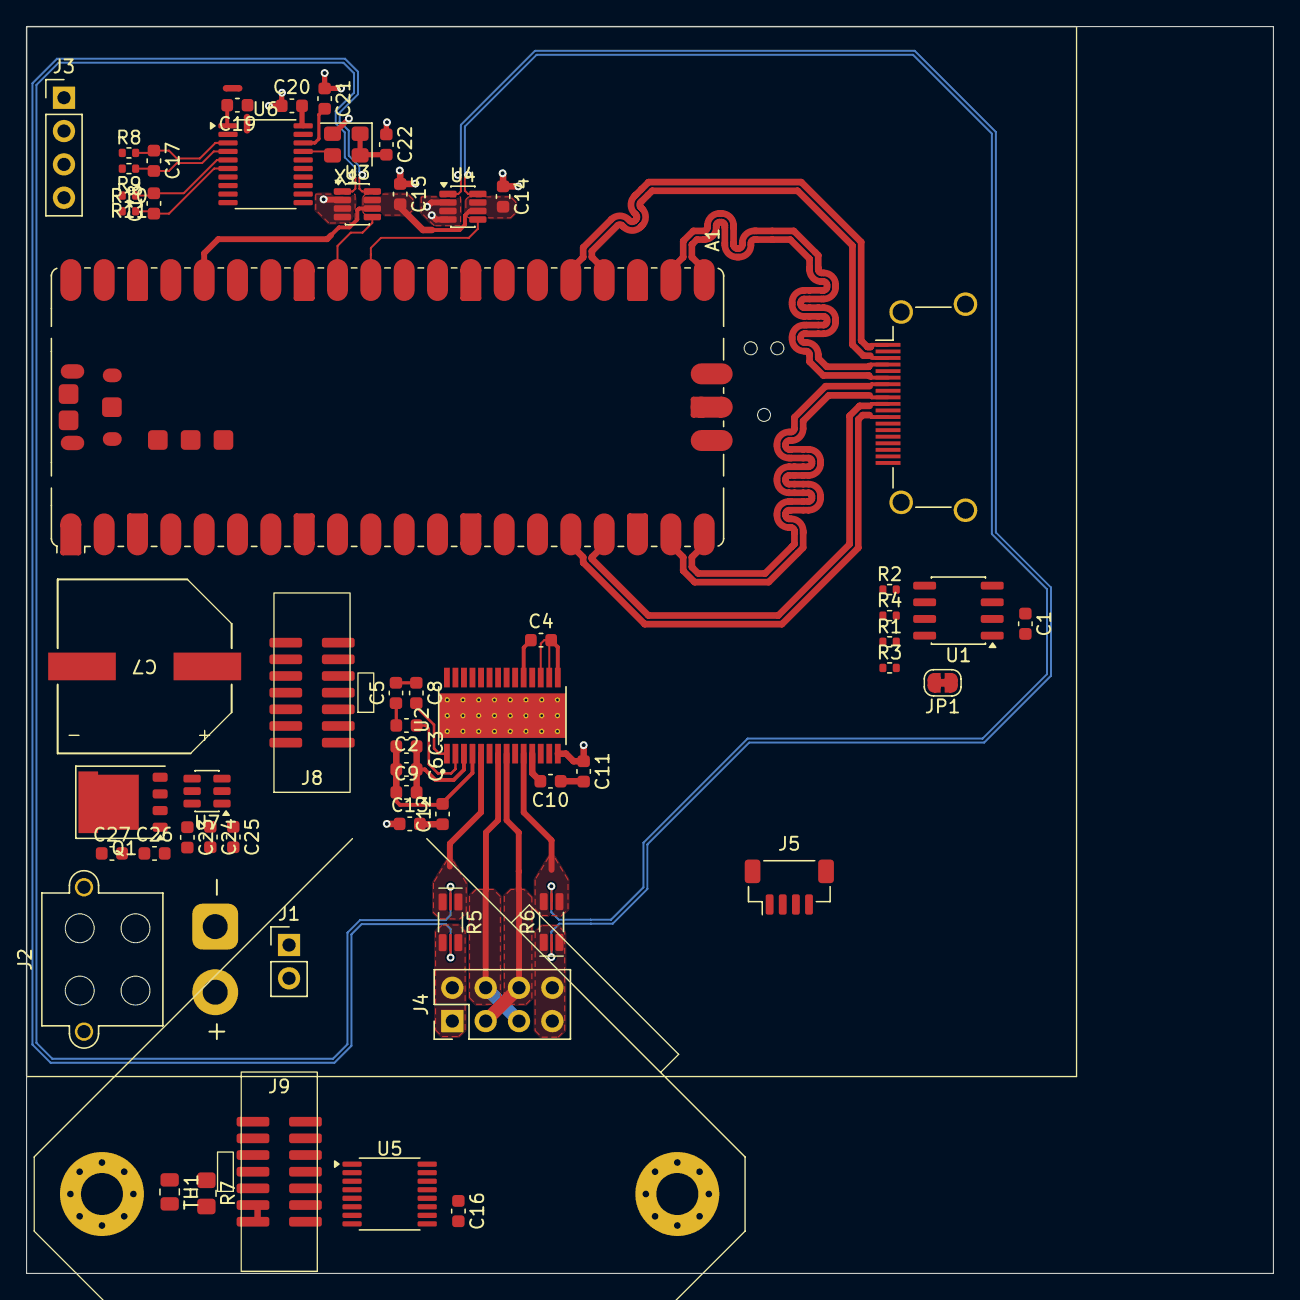
[picture p15: board dual_core_foc_micropy.kicad_pcb from above]

Board: 2 copper layers, 95.0 x 95.0 mm, 67 parts (1 on the bottom side), 74 nets.
